hansung-capstone-team-8-new-line/deskpet-hardware/hardware-design/case-3d/check-report.txt

DeskPet 케이스 3D 모델 rev E 검사 (앞면 전체 LCD · 둥근 외형, [추정] 값은 실측 후 deskpet_case.py 치수 표에서 수정)
외형 192 × 150 × 134 mm (귀 포함 높이 174, 아래로 발 7 + 범퍼 2 mm 별도)
앞틀 192 × 128 mm 중 LCD 유리 164.9 × 106.96 = 72%, 테두리 좌우 13.5 · 위아래 13.5 mm, 창 162.9 × 105.0 (표시 영역 154.21 × 85.92는 모두 보임)

[PASS] 출력물·부품끼리 겹침 없음
[PASS] 배선이 출력물을 뚫지 않음
[PASS] Jetson 팬 위 공기층 30 mm 비어 있음
[PASS] 귀가 ±30° 돌 때 부딪힘 없음 (멈춤 나사 포함)
[PASS] 귀를 ±40°까지 돌리면 멈춤 나사에 걸림 (최소 겹침 5.1 mm³ → 서보 스톨 전에 기계적으로 멈춤)
[PASS] 뒤판을 열지 않고 Jetson 트레이를 뒤로 끝까지 뺄 수 있음
[PASS] 귀 1개 무게 8.8 g (속 채움 100% 상한, 기준 10 g 이하)
    참고: P1 바닥판 바닥 2 mm 안 수평 다리 75 mm² (나사 머리 자리·혼 홈 등)
    참고: P3 윗판 바닥 2 mm 안 수평 다리 90 mm² (나사 머리 자리·혼 홈 등)
    참고: P6 왼쪽 귀 바닥 2 mm 안 수평 다리 60 mm² (나사 머리 자리·혼 홈 등)
    참고: P6 오른쪽 귀 바닥 2 mm 안 수평 다리 60 mm² (나사 머리 자리·혼 홈 등)
[PASS] 출력 방향에서 바닥 2 mm 안에 45°보다 눕힌 경사면 없음 (첫 층부터 받침이 있음)

출력 범위 (출력 방향 기준 가로 × 세로 × 높이) · 무게는 속 채움 100% PLA 기준 상한
  [PASS] P1 바닥판        192 × 150 × 10 mm  부피   81.4 cm³  최대   101 g  출력 가능: X1C · H2D
  [PASS] P2 몸통        192 × 128 × 148 mm  부피  121.8 cm³  최대   151 g  출력 가능: X1C · H2D
  [PASS] P3 윗판         188 × 147 × 10 mm  부피   82.8 cm³  최대   103 g  출력 가능: X1C · H2D
  [PASS] P4 뒤판         187 × 128 × 11 mm  부피   40.8 cm³  최대    51 g  출력 가능: X1C · H2D
  [PASS] P5 트레이        136 × 106 × 49 mm  부피   37.4 cm³  최대    46 g  출력 가능: X1C · H2D
  [PASS] P6 왼쪽 귀         50 × 31 × 40 mm  부피    7.1 cm³  최대     9 g  출력 가능: X1C · H2D
  [PASS] P7 스피커 받침        74 × 34 × 6 mm  부피    3.0 cm³  최대     4 g  출력 가능: X1C · H2D
  [PASS] P8 발 ×4        166 × 124 × 7 mm  부피   13.1 cm³  최대    16 g  출력 가능: X1C · H2D

참고: LCD 오른쪽 끝 x=178.45, 옆벽 안쪽 x=189.5. 남는 11.1 mm에 HDMI FPC ㄱ자 플러그(8.6 mm)와 ㄱ자 micro USB(7 mm)를 넣었다. 일자 플러그·일반 ㄱ자 HDMI 젠더(약 20 mm 이상)는 들어가지 않는다.

H2D 출력 계획 (한 번에 300 g까지, 퍼지·브림 몫 10%를 빼고 물체 무게 상한 270 g 이하, 속 채움 100% PLA 기준 · 물체 간격 20 mm · 가운데 275 × 300 mm 안)
  [PASS] 시험 H2D-0-P2-fit-test.3mf: P2 앞틀 시험편 12 mm (판 위 192 × 128 × 12 mm) · 최대 28 g
  [PASS] 1회차 H2D-1-P2-body-P7-P8-feet.3mf: P2 몸통, P7 스피커 받침, P8 발 1, P8 발 2, P8 발 3, P8 발 4 (판 위 258 × 183 × 148 mm) · 최대 171 g
  [PASS] 2회차 H2D-2-P1-base-P4-back.3mf: P1 바닥판, P4 뒤판 (판 위 192 × 298 × 11 mm) · 최대 152 g
  [PASS] 3회차 H2D-3-P3-top-P5-tray-P6-ears.3mf: P3 윗판, P5 트레이, P6 왼쪽 귀, P6 오른쪽 귀 (판 위 206 × 273 × 49 mm) · 최대 167 g
  본 출력 합계 최대 489 g (시험편 제외)

결과: 모든 검사 통과
