hansung-capstone-team-8-new-line/deskpet-hardware/hardware-design/case-3d/renders/03-inside-back-right.png

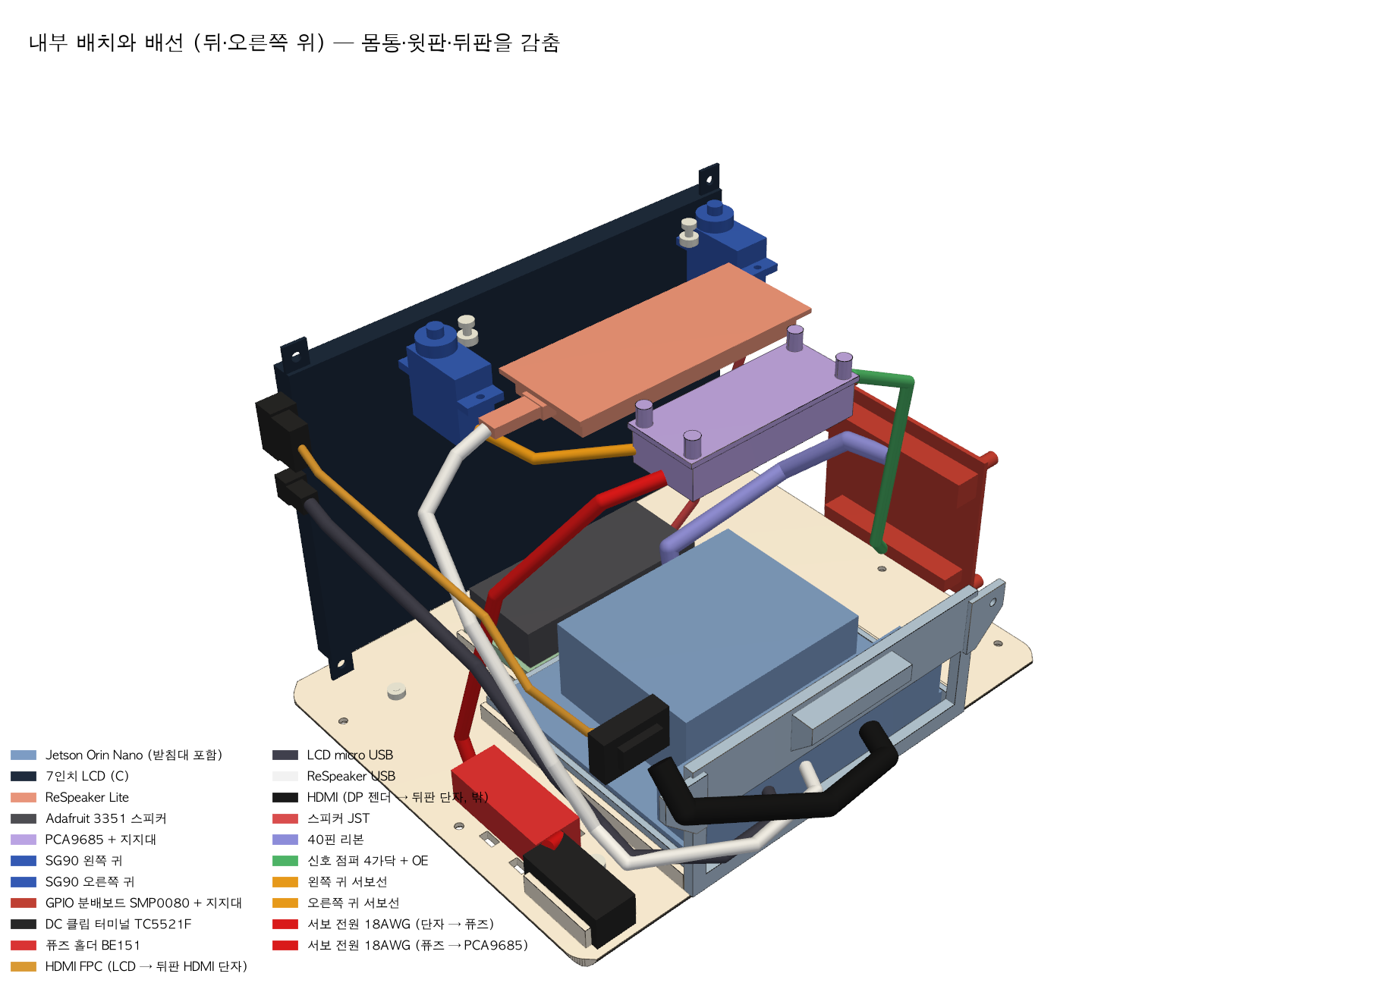
hardware-design/case-3d/renders/03-inside-back-right.png
