hansung-capstone-team-8-new-line/deskpet-hardware/hardware-design/case-3d/renders/03b-inside-front-left.png

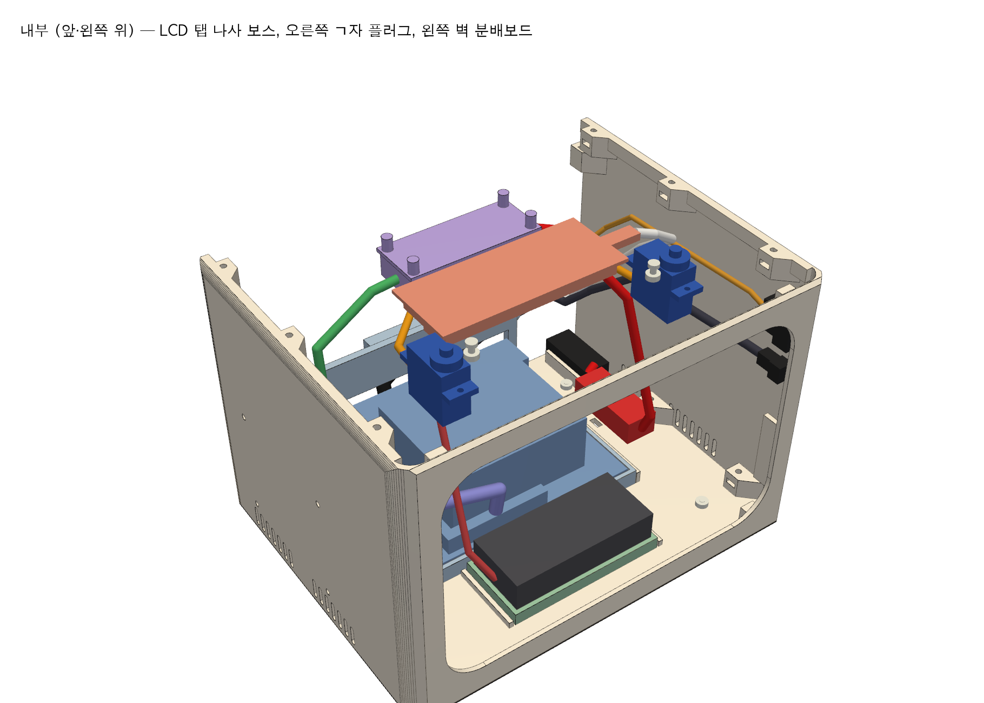
hardware-design/case-3d/renders/03b-inside-front-left.png
