hansung-capstone-team-8-new-line/deskpet-hardware/hardware-design/case-3d/renders/04-top-plate-underside.png

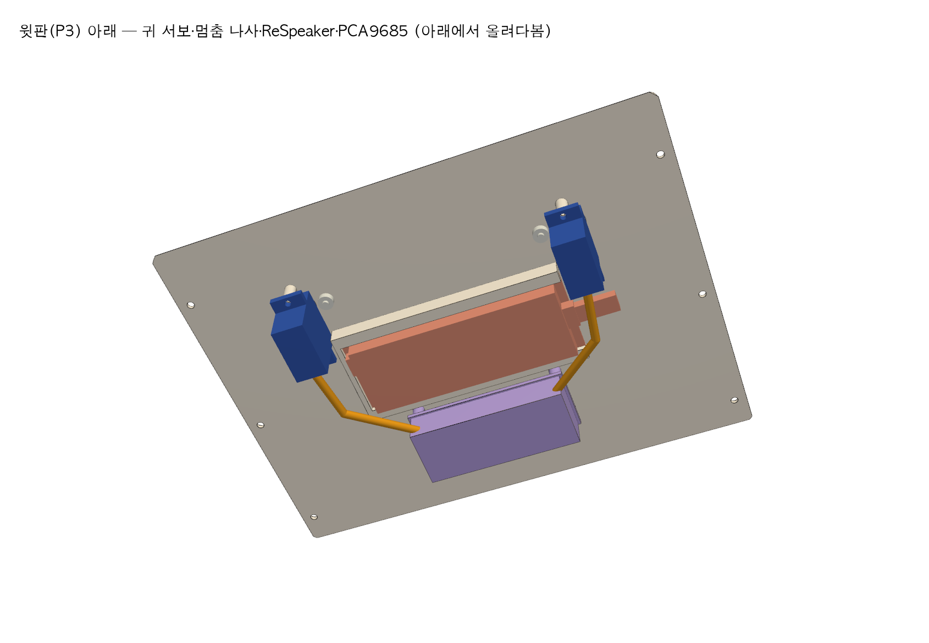
hardware-design/case-3d/renders/04-top-plate-underside.png
