hansung-capstone-team-8-new-line/deskpet-hardware/hardware-design/case-3d/renders/05-exploded.png

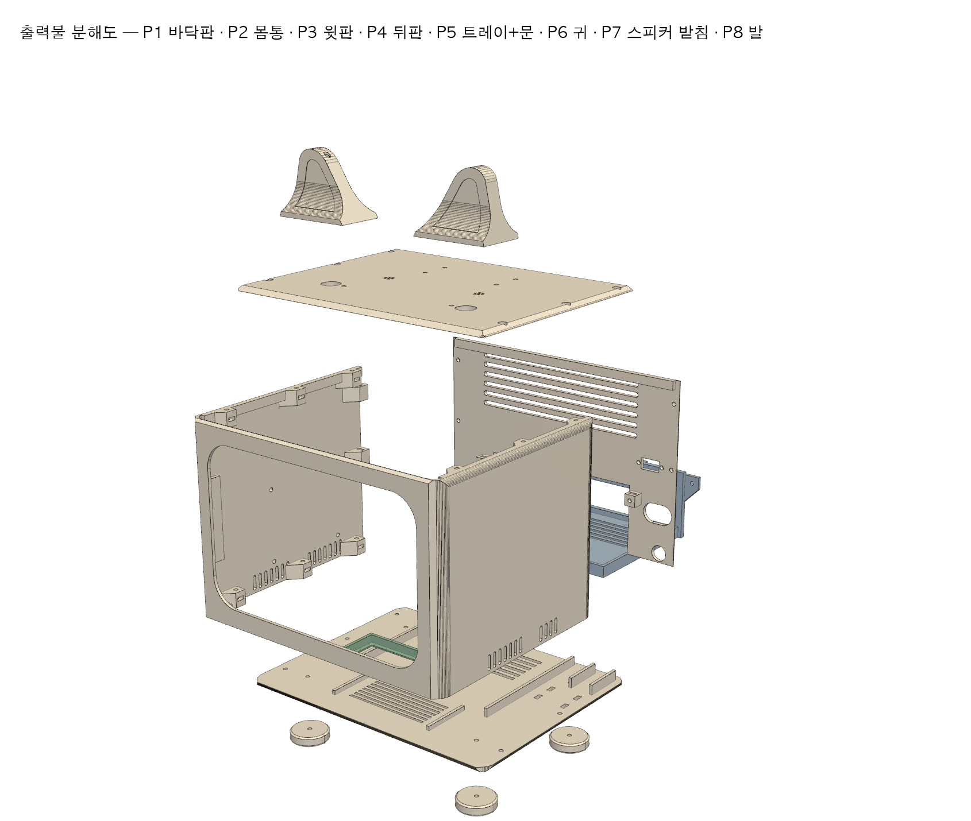
hardware-design/case-3d/renders/05-exploded.png
