hansung-capstone-team-8-new-line/deskpet-hardware/hardware-design/kicad-wiring/deskpet-schematic.png

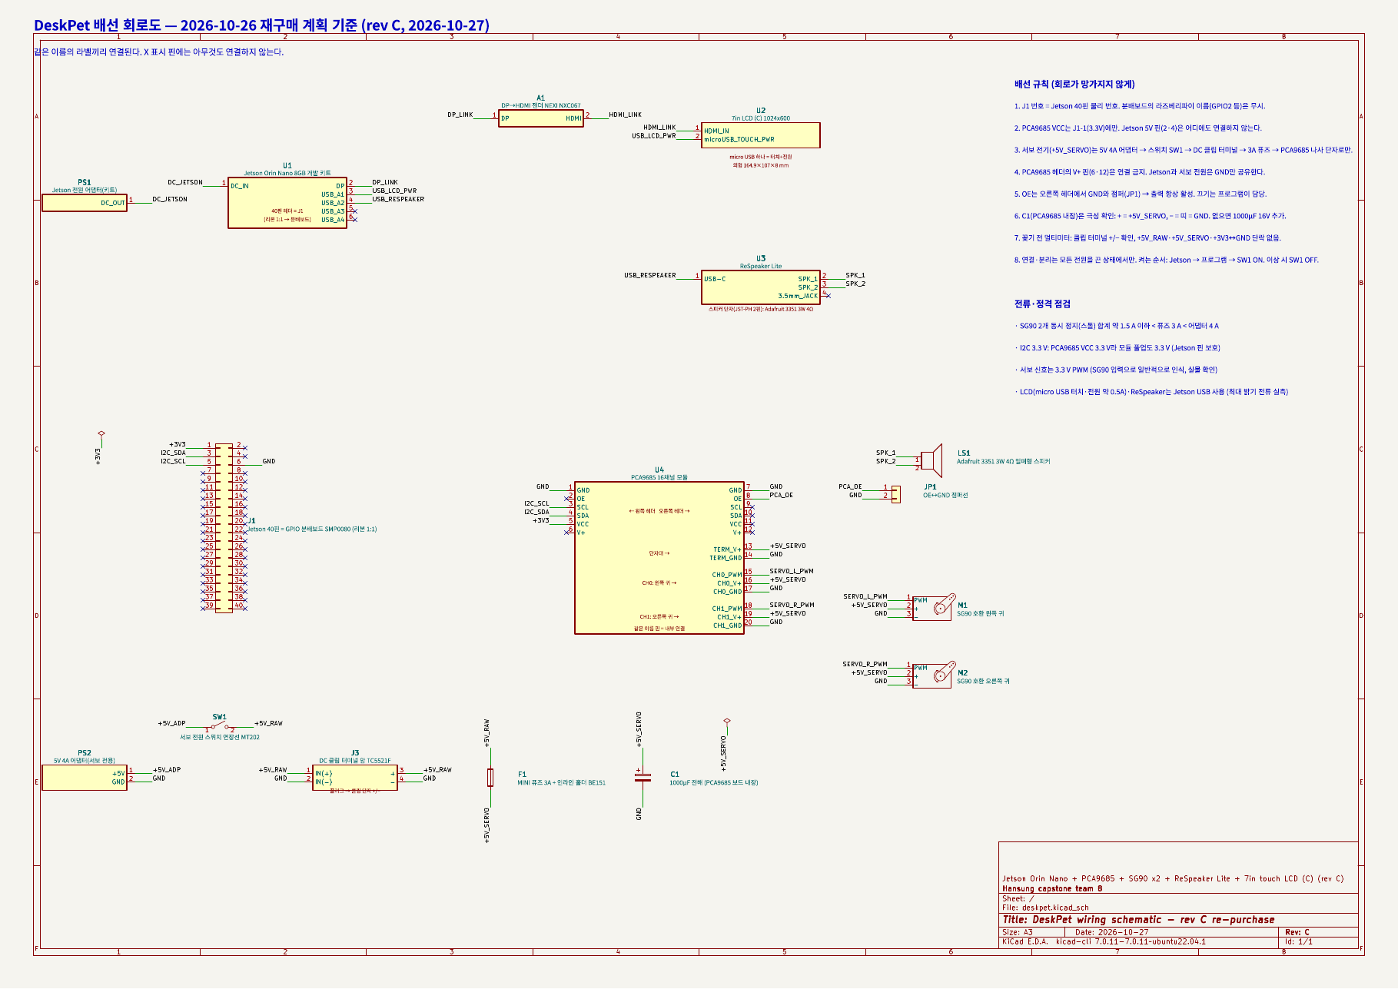
hardware-design/kicad-wiring/deskpet-schematic.png
