hansung-capstone-team-8-new-line/deskpet-hardware/hardware-design/case-3d/deskpet-case-assembly.step

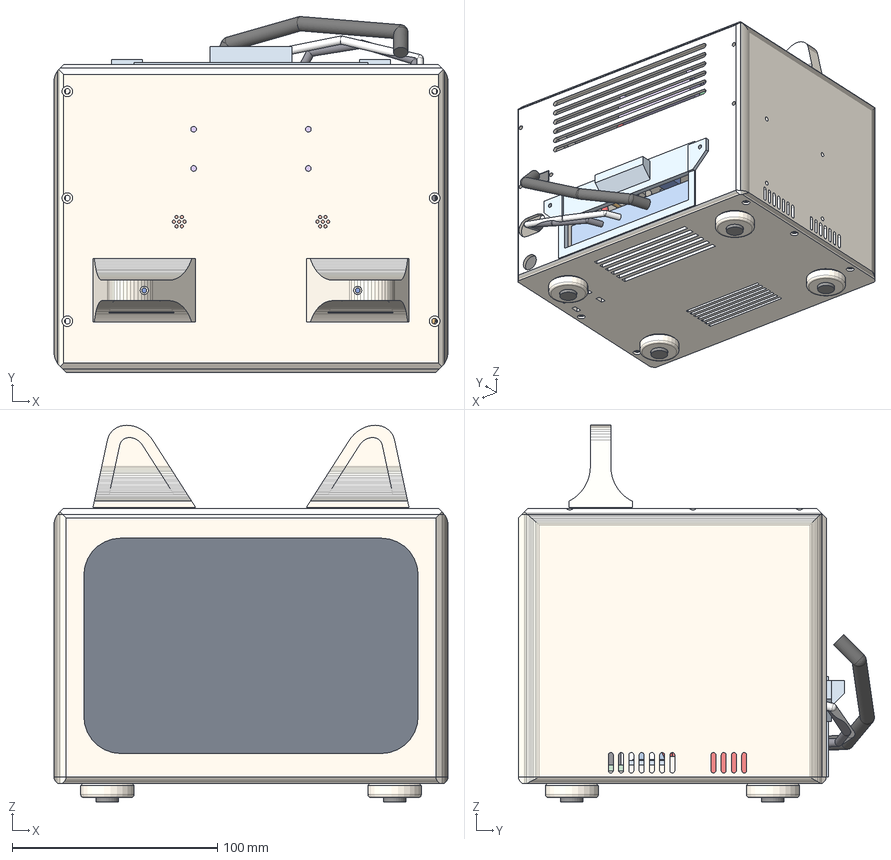
[picture p10: CAD file, 2026-11-09]
hardware-design/case-3d/deskpet-case-assembly.step
192.0 x 173.5 x 183.5 mm
P1 ë°ë¥í
P2 ëª¸íµ
P3 ìí
P4 ë¤í
P5 í¸ë ì´
P6 ì¼ìª½ ê·
P6 ì¤ë¥¸ìª½ ê·
P7 ì¤í¼ì»¤ ë°ì¹¨
P8 ë° Ã4
Jetson Orin Nano (ë°ì¹¨ë í¬í¨)
7ì¸ì¹ LCD (C)
HDMI FPC ã±ì íë¬ê·¸
micro USB ã±ì íë¬ê·¸
HDMI FPC ì ë¨ì ë³´ë
ReSpeaker Lite
Adafruit 3351 ì¤í¼ì»¤
PCA9685 + ì§ì§ë
SG90 ì¼ìª½ ê·
SG90 ì¤ë¥¸ìª½ ê·
ê· ë©ì¶¤ ëì¬ M2.5 Ã2
GPIO ë¶ë°°ë³´ë SMP0080 + ì§ì§ë
DC í´ë¦½ í°ë¯¸ë TC5521F
í¨ì¦ íë BE151
ì¤ë¦¬ì½ ë²í¼ Ã4
ë° ëì¬ M2.5 Ã8 + ëí¸ Ã4
HDMI FPC (LCD â ë¤í HDMI ë¨ì)
LCD micro USB
ReSpeaker USB
HDMI (DP ì ë â ë¤í ë¨ì, ë°)
ì¤í¼ì»¤ JST
40í ë¦¬ë³¸
ì í¸ ì í¼ 4ê°ë¥ + OE
ì¼ìª½ ê· ìë³´ì
ì¤ë¥¸ìª½ ê· ìë³´ì
ìë³´ ì ì 18AWG (ë¨ì â í¨ì¦)
ìë³´ ì ì 18AWG (í¨ì¦ â PCA9685)
