hansung-capstone-team-8-new-line/deskpet-hardware/hardware-design/case-3d/3mf/H2D-3-P3-top-P5-tray-P6-ears.3mf

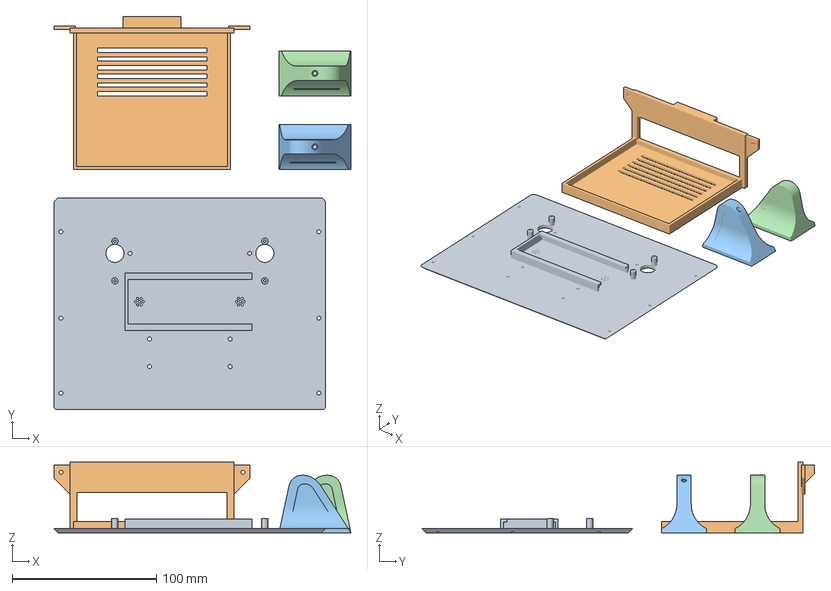
[picture p11: CAD file, 2026-11-09]
hardware-design/case-3d/3mf/H2D-3-P3-top-P5-tray-P6-ears.3mf
206.0 x 272.6 x 49.0 mm
