hansung-capstone-team-8-new-line/deskpet-hardware/hardware-design/case-3d/stl/P2-body.stl

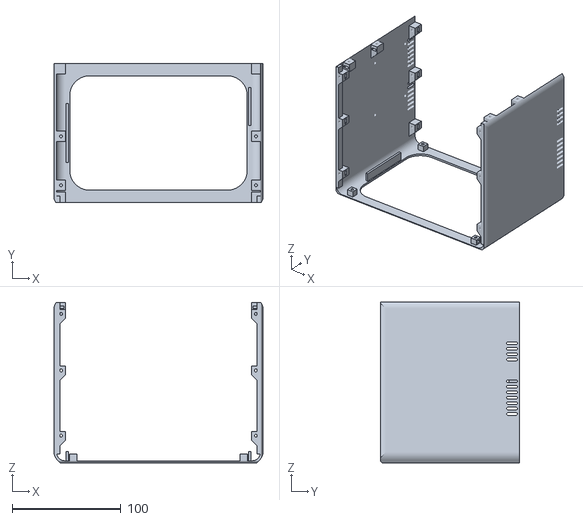
[picture p12: CAD file, 2026-11-09]
hardware-design/case-3d/stl/P2-body.stl
192.0 x 128.0 x 147.8
