hansung-capstone-team-8-new-line/deskpet-hardware/hardware-design/case-3d/3mf/H2D-0-P2-fit-test.3mf

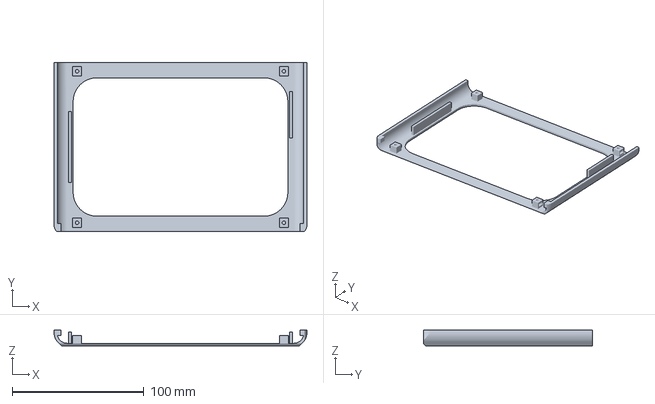
[picture p13: CAD file, 2026-11-09]
hardware-design/case-3d/3mf/H2D-0-P2-fit-test.3mf
192.0 x 128.0 x 12.0 mm
