hansung-capstone-team-8-new-line/deskpet-hardware/hardware-design/case-3d/stl/P5-tray-door.stl

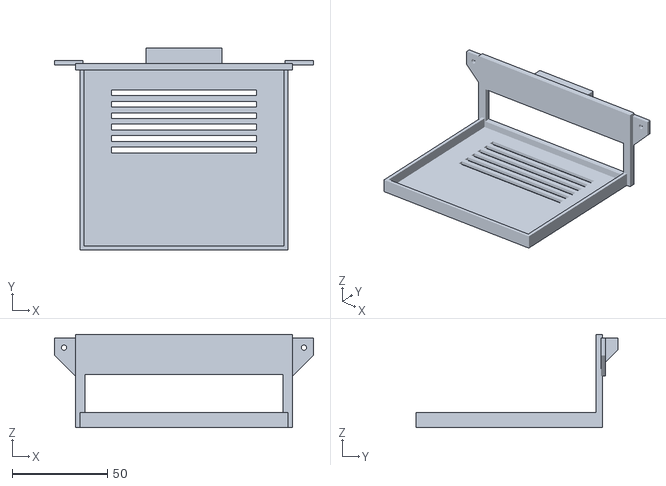
[picture p14: CAD file, 2026-11-09]
hardware-design/case-3d/stl/P5-tray-door.stl
136.0 x 106.0 x 49.0
