hansung-capstone-team-8-new-line/deskpet-hardware/hardware-design/case-3d/3mf/H2D-1-P2-body-P7-P8-feet.3mf

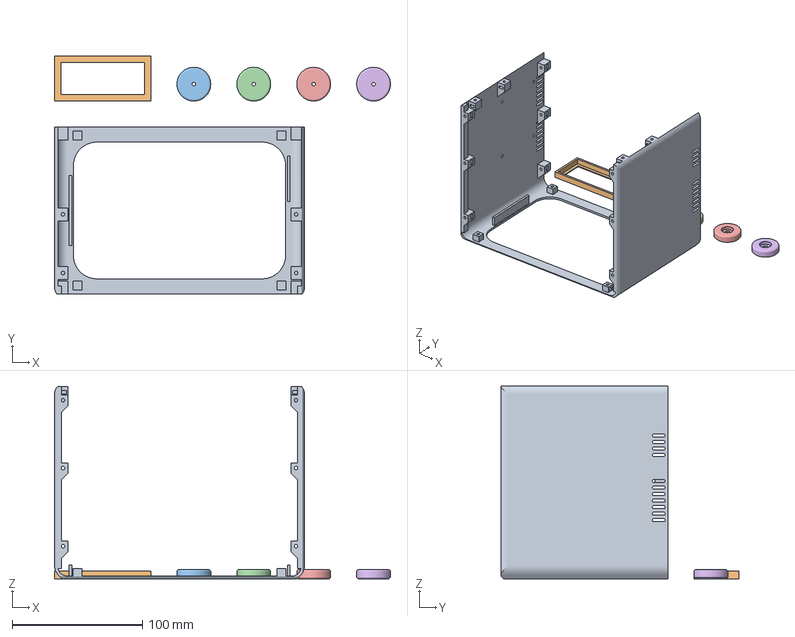
[picture p15: CAD file, 2026-11-09]
hardware-design/case-3d/3mf/H2D-1-P2-body-P7-P8-feet.3mf
258.0 x 182.5 x 147.8 mm
