hansung-capstone-team-8-new-line/deskpet-hardware/hardware-design/case-3d/stl/P3-top.stl

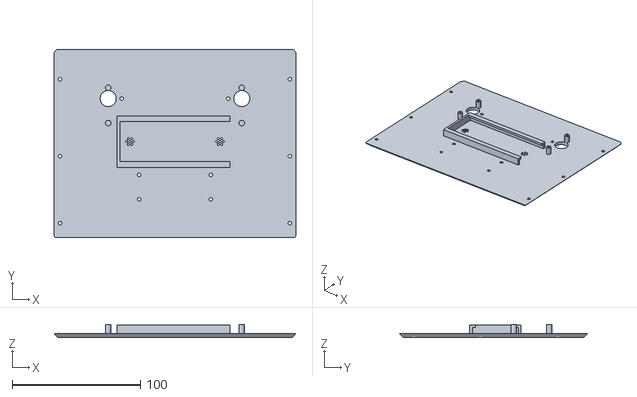
[picture p16: CAD file, 2026-11-09]
hardware-design/case-3d/stl/P3-top.stl
188.5 x 146.6 x 9.80
