hansung-capstone-team-8-new-line/deskpet-hardware/hardware-design/case-3d/3mf/H2D-2-P1-base-P4-back.3mf

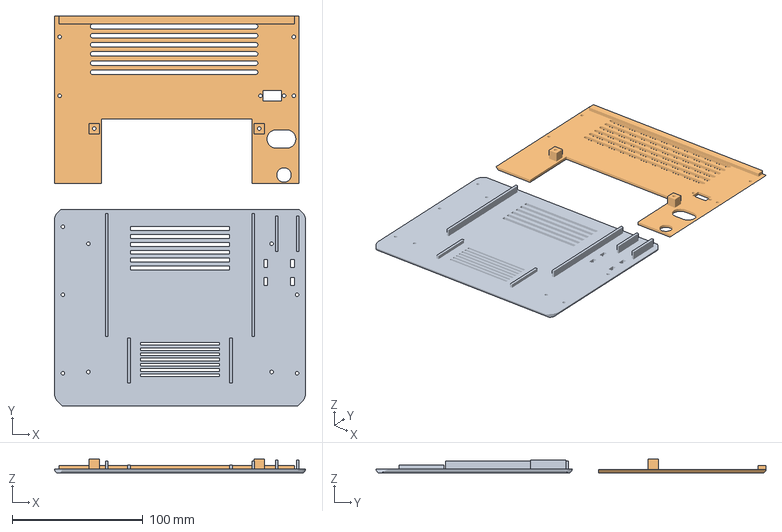
[picture p17: CAD file, 2026-11-09]
hardware-design/case-3d/3mf/H2D-2-P1-base-P4-back.3mf
192.0 x 298.0 x 10.5 mm
