hansung-capstone-team-8-new-line/deskpet-hardware/hardware-design/case-3d/stl/P1-base.stl

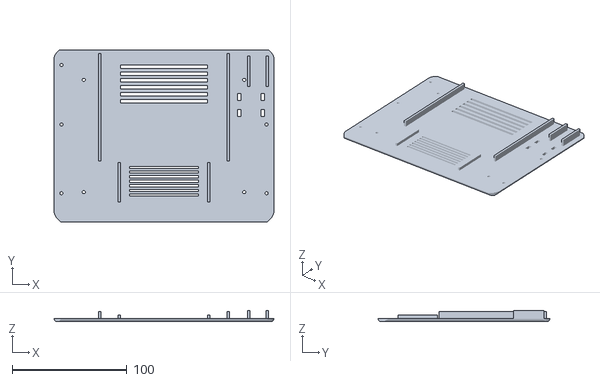
[picture p18: CAD file, 2026-11-09]
hardware-design/case-3d/stl/P1-base.stl
192.0 x 150.0 x 10.00
