hansung-capstone-team-8-new-line/deskpet-hardware/hardware-design/case-3d/stl/P8-foot-x4.stl

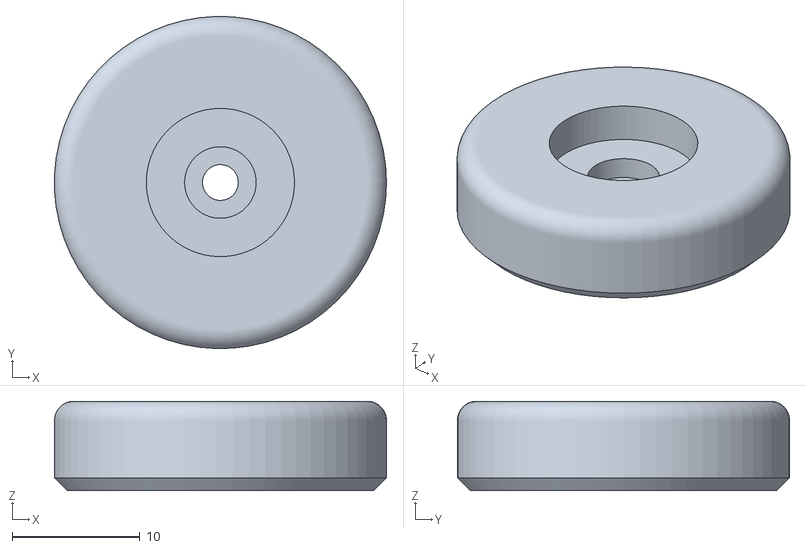
[picture p19: CAD file, 2026-11-09]
hardware-design/case-3d/stl/P8-foot-x4.stl
26.0 x 26.0 x 7.00
