hansung-capstone-team-8-new-line/deskpet-hardware/hardware-design/case-3d/stl/P4-back.stl

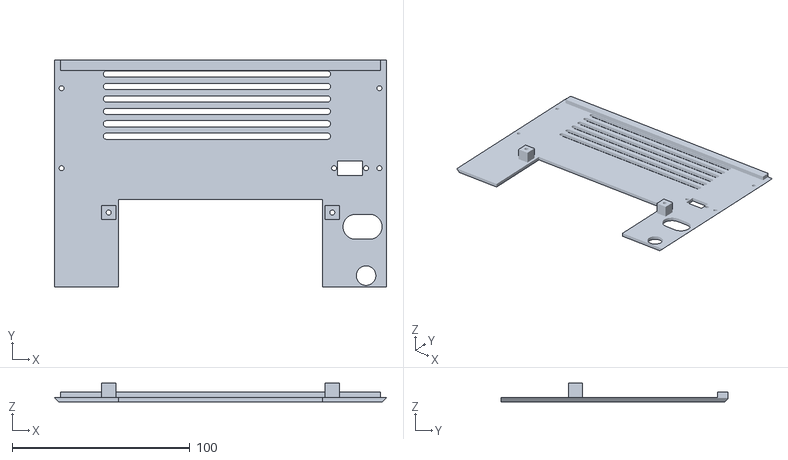
[picture p20: CAD file, 2026-11-09]
hardware-design/case-3d/stl/P4-back.stl
187.0 x 128.0 x 10.5
