hansung-capstone-team-8-new-line/deskpet-hardware/hardware-design/case-3d/stl/P6-ear-left.stl

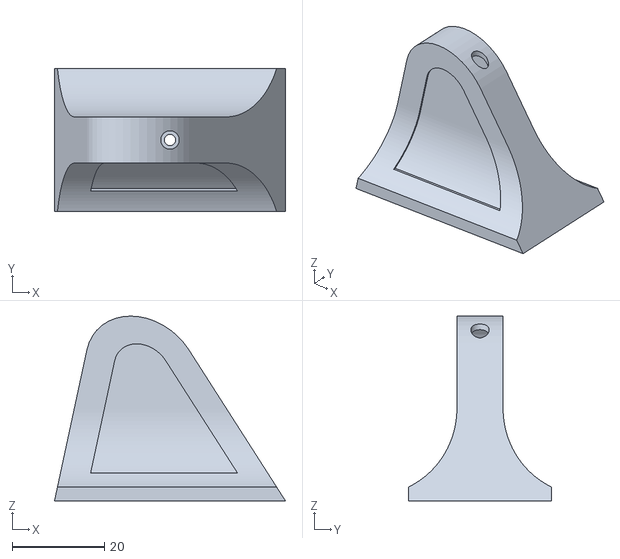
[picture p21: CAD file, 2026-11-07]
hardware-design/case-3d/stl/P6-ear-left.stl
50.0 x 31.0 x 40.0
