hansung-capstone-team-8-new-line/deskpet-hardware/hardware-design/case-3d/stl/P7-speaker-cradle.stl

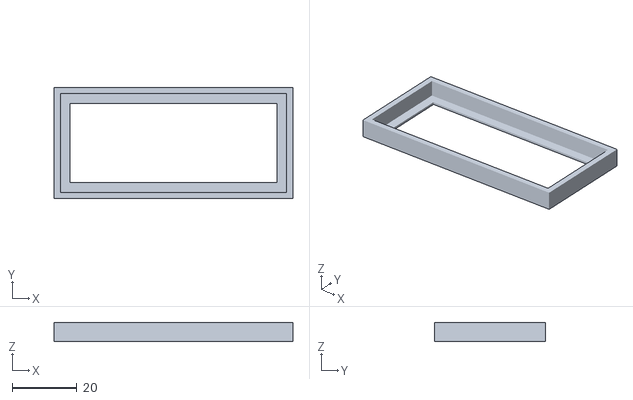
[picture p22: CAD file, 2026-11-07]
hardware-design/case-3d/stl/P7-speaker-cradle.stl
74.0 x 34.5 x 6.00
