hansung-capstone-team-8-new-line/deskpet-hardware/(list of files, cad)

Other CAD files:
hardware-design/case-3d/stl/P6-ear-right.stl
