hansung-capstone-team-8-new-line/deskpet-hardware/hardware-design/case-3d/PRINTING.md

# 케이스 출력 안내 (Bambu Lab H2D, rev E)

출력물 8종(P1~P8)을 **H2D 한 대에서 본 출력 3회 + 맞춤 시험 1회**로 뽑습니다. 한 번에 출력할 수 있는 양이 **300 g**이고, 판 위 물체를 **20 mm 이상** 띄워 브림과 떼어내기 여유를 두었습니다. `build.py`가 판마다 ① 물체 무게 상한이 270 g(퍼지·브림 몫 10%를 뺀 값) 이하인지, ② 배치가 판 가운데 275 × 300 mm 안에 드는지(양옆 "한쪽 노즐 전용" 띠를 피함) 검사하고(`check-report.txt` 아래쪽), 넘으면 실패로 끝납니다.

`stl/`은 출력 방향으로 돌려 둔 부품별 파일이고, `3mf/`는 그 부품을 아래 계획대로 H2D 판(325 × 320) 가운데에 배치해 둔 파일입니다.

> **본 출력 전에:** LCD·Jetson 등 부품이 도착하면 [README](README.md) 맨 아래 `[추정]` 값을 실측해 고치고 `build.py`를 다시 실행하세요. 1회차(P2)는 LCD 탭 깊이·단자 위치, 2·3회차(P1·P3)는 PCA9685 구멍·ReSpeaker·마이크 위치에 영향을 받습니다.

## 출력 계획

| 순서 | 파일 | 출력물 | 판 위 크기 (mm) | 무게 상한* |
| --- | --- | --- | --- | ---: |
| 0. 시험 | `3mf/H2D-0-P2-fit-test.3mf` | P2 앞틀 시험편 (앞면부터 12 mm) | 192 × 128 × 12 | 28 g |
| 1회차 | `3mf/H2D-1-P2-body-P7-P8-feet.3mf` | P2 몸통, P7 스피커 받침, P8 발 4개 | 258 × 183 × 148 | 171 g |
| 2회차 | `3mf/H2D-2-P1-base-P4-back.3mf` | P1 바닥판, P4 뒤판 | 192 × 298 × 11 | 152 g |
| 3회차 | `3mf/H2D-3-P3-top-P5-tray-P6-ears.3mf` | P3 윗판, P5 트레이+문, P6 귀 2개 | 206 × 273 × 49 | 167 g |
| | | **본 출력 합계** | | **489 g** |

\* 속 채움 100% PLA(1.24 g/cm³)로 계산한 **상한**입니다. 실제 슬라이서 값은 아래 설정(벽 3, 속 채움 20%)에서 이보다 적게 나옵니다(대략 20~40% 적을 것으로 추정). **보내기 전에 Bambu Studio의 슬라이스 결과에 나온 무게가 300 g 이하인지 확인**하세요(퍼지·브림 포함 값).

나눈 이유:

- **1회차 = 키 큰 P2.** 높이 148 mm라 가장 오래 걸리고 실패 위험도 가장 큽니다. 같은 판에는 작은 P7·발만 넣어, 실패해도 잃는 양이 적습니다.
- **2회차 = 납작한 판 두 장.** P1·P4는 높이 11 mm 이하라 빨리 끝납니다.
- **3회차 = P3과 작은 부품.** P5(높이 49)와 귀(높이 40)를 P3 앞쪽에 둡니다.
- 판마다 270 g보다 100 g 가까이 여유가 있어 브림을 키우거나 시험편을 다시 넣어도 넘지 않습니다.

순서는 **시험 → 실측값 수정·재생성 → 1회차 → 2회차 → 3회차**입니다. 2·3회차는 서로 순서를 바꿔도 됩니다.

**3MF 여는 법:** Bambu Studio → 파일 → 가져오기 → 3MF. "기하만 불러오기" 안내가 나오면 예를 누릅니다. 프린터 H2D·노즐 0.4·텍스처드 PEI 판을 고르고, 한 노즐(왼쪽 또는 오른쪽)에 PLA Basic 한 가지만 지정합니다. 물체 위치를 옮기면 판 양옆의 "Left/Right nozzle only area" 띠에 걸치지 않게, 물체끼리는 20 mm 이상 띄워 두세요.

## 재료: Bambu PLA Basic 한 가지

| 출력물 | 재료 | 이유 |
| --- | --- | --- |
| P1~P8 전부 | **Bambu PLA Basic**, 흰색·밝은 회색 권장 | 가지고 있는 필라멘트. 아크릴(시타델) 도료가 PETG보다 잘 붙음. 필라멘트 교체·두 노즐 출력이 필요 없음 |
| 맞춤 시험편 | PLA Basic | 맞춤 확인용 |

**열 주의:** PLA Basic은 약 55~57 °C부터 물러집니다. Jetson을 오래 세게 돌리면 케이스 안, 특히 P5 트레이·P4 뒤판(배기)·P3 윗판(팬 위)이 그 근처까지 데워질 수 있습니다(실측 전 추정). Jetson은 키트 받침대째 얹혀 보드가 PLA에 직접 닿지 않고 팬 위 30 mm 공기층과 흡기·배기 길이 있어 대개 괜찮지만, 다음을 지킵니다.

1. 조립 후 첫 시험에서 Jetson에 30분~1시간 부하를 걸고 `tegrastats`로 온도를 보며 P4·P5·P3을 만져 봅니다. 손으로 오래 대기 어려울 만큼 뜨겁거나 말랑해지면 문제입니다.
2. 문제가 생기면 Jetson 전력 모드를 낮추거나(`nvpmodel`), **P4·P5만 PETG 등으로 다시 출력**합니다(합계 약 100 g).
3. 직사광선·여름 차 안 같은 곳에 두지 않습니다.

색은 시타델 도료로 칠하므로 출력 색은 상관없습니다. 밑칠이 잘 덮이도록 흰색이나 밝은 회색이 편합니다.

## 공통 설정 (0.4 노즐)

| 항목 | 값 |
| --- | --- |
| 층 높이 | 0.20 mm (3회차는 귀 곡면을 위해 0.16 mm도 좋음) |
| 벽 루프 | 3 (귀 벽 1.2 mm는 3이면 꽉 참. 도색 자리 아래는 0.8 mm = 2줄) |
| 위/아래 층 | 4 / 4 |
| 속 채움 | 20% 자이로이드 |
| 서포트 | **끔** (모든 경사를 45° 이하로 설계) |
| 판 | 텍스처드 PEI (풀 불필요) |
| 브림 | P2만 5 mm (높이 148, 무게중심이 높음). Bambu Studio에서 P2 물체에만 브림을 켭니다 |
| 이음매 | 뒤쪽 정렬 (앞틀 정면에 이음매가 보이지 않게) |

출력물별 주의:

- **P2 몸통:** 앞면이 바닥이라 첫 층이 그대로 정면 마감이 됩니다. 판을 닦고 첫 층 속도를 낮추세요. 바닥에 닿는 둥근 모서리는 모두 45° 직선으로 시작하게 만들어 서포트가 필요 없습니다(`build.py` "첫 층 들뜸" 검사). P1·P3·P4도 같습니다.
- **P3 윗판:** 윗면이 바닥입니다. 레일 끝 걸림턱(돌출 2.5 mm)은 서포트 없이 출력됩니다.
- **P4 뒤판:** 바깥면이 바닥입니다. 문 나사 너트 보스가 위로 섭니다.
- **P5 트레이+문:** 문 밑면이 트레이 밑면과 같은 높이라 둘 다 바닥에 닿습니다. 문의 Jetson 단자 창 윗변이 약 104 mm 다리(bridge)입니다. 처지면 그 부분만 서포트를 칠하세요(서포트 칠하기 → 창 윗변).
- **P6 귀:** 귀 뿌리 밑면이 바닥이고 속이 열려 있습니다. 뿌리 곡면은 밑에서 26°로 시작해 서포트가 필요 없습니다. 왼쪽과 오른쪽은 멈춤 홈 방향과 기운 방향이 달라 서로 바꿔 끼우면 안 됩니다. 혼 팔은 **뒤쪽 한 방향**만 홈이 있으니 SG90 혼의 팔 하나를 13 mm로 잘라 씁니다.
- **P8 발:** 위면(바닥판에 닿는 면, 둘레 1 mm 모따기)이 바닥입니다. 범퍼 자리(Ø11.6, 깊이 3)와 나사 머리 자리가 위로 열립니다.

## 맞춤 시험 (0번, 먼저 권장)

LCD가 도착하면 P2 전체를 뽑기 전에 `3mf/H2D-0-P2-fit-test.3mf`(앞틀 앞쪽 12 mm)를 출력합니다. 앞틀·창·LCD 탭 보스·좌우 리브와 둥근 모서리 첫 층이 포함됩니다.

1. LCD를 대어 봅니다: 탭 구멍과 보스 구멍이 맞는지, 유리가 앞틀에 고르게 닿는지, 오른쪽 HDMI FPC·micro USB ㄱ자 플러그가 옆벽에 닿지 않는지.
2. 어긋나면 `deskpet_case.py`의 `LCD` 표를 고치고 `build.py`를 다시 실행합니다(3MF도 다시 만들어집니다).

## 도색 (시타델 도료)

귀 앞면 안쪽은 **0.4 mm 낮춘 도색 자리**입니다. 이 턱을 경계선 삼아 분홍을 칠하면 선이 깔끔하게 나옵니다(그림의 분홍 부분).

1. 바깥에 보이는 부품(P1~P4, P6, P8)을 가볍게 사포질(400~600방)하고 먼지를 닦습니다.
2. 시타델 스프레이 프라이머(예: Wraithbone, White Scar)를 얇게 두 번 뿌립니다.
3. 몸통 색 → 귀 안쪽 분홍 순으로 칠하고, 다 마르면 무광 바니시(예: Munitorum Varnish)로 마감합니다.
4. 실리콘 범퍼와 나일론 나사는 도료가 붙지 않습니다. **발은 칠한 뒤에 범퍼를 붙이고**, 나사 머리는 칠하지 않거나 프라이머로 시험해 봅니다.
5. 끼워 맞추는 면(트레이 레일, 귀 허브 아래, LCD가 닿는 앞틀 안쪽, 나사 구멍)은 칠하지 않습니다. 도막 두께만큼 빡빡해집니다.

## 조립에 필요한 것 (케이스 관련)

| 품목 | 수량 | 비고 |
| --- | --- | --- |
| M2.5 나일론 나사 + 너트 | 33쌍 | 판 결합 15, 문 2, LCD 탭 4, 귀 멈춤 2, HDMI 단자 보드 2, PCA9685 4, **발 4(M2.5 × 8)** (BRT 세트). 분배보드 지지대는 별도 |
| HDMI FPC 리본 키트 | 1 | 구매 완료. LCD 쪽 A수 90° 위/아래 꺾임(돌출 9 mm 이하) + 리본 + A암 패널형 보드. 꺾임 방향은 LCD 실물로 확인 |
| ㄱ자 micro USB 케이블 | 1 | 구매 완료. 위/아래 꺾임, 머리 돌출 7 mm 이하, USB-A 쪽은 Jetson으로 |
| 짧은 HDMI 케이블 (A수-A수) | 1 | DP→HDMI 젠더 ↔ 뒤판 HDMI 단자. LCD 동봉 케이블 사용 가능 |
| 실리콘 범퍼 Ø11 × 5 | 4 | P8 발 바닥 자리에 3 mm 묻혀 2 mm만 보임 |
| EVA 테이프 | 조금 | 스피커 받침 가장자리, 트레이가 헐거울 때 |
