hansung-capstone-team-8-new-line/deskpet-hardware/hardware-design/kicad-wiring/wiring-table.csv

번호 | 출발 | 도착 | 선·부품 | 색 | 넷
R | Jetson 40핀 헤더 | GPIO 분배보드 SMP0080 | 40p 무지개 리본(세트 동봉) | 1번 = 리본 첫 줄 | 리본 1:1
W1 | 분배보드 1번 (3.3V) | PCA9685 왼쪽 헤더 VCC | F/F 점퍼 | 빨강 | +3V3
W2 | 분배보드 3번 (SDA) | PCA9685 왼쪽 헤더 SDA | F/F 점퍼 | 파랑 | I2C_SDA
W3 | 분배보드 5번 (SCL) | PCA9685 왼쪽 헤더 SCL | F/F 점퍼 | 노랑 | I2C_SCL
W4 | 분배보드 6번 (GND) | PCA9685 왼쪽 헤더 GND | F/F 점퍼 | 검정 | GND
W5 | PCA9685 오른쪽 헤더 OE | PCA9685 오른쪽 헤더 GND | 짧은 F/F 점퍼 (JP1) | 초록 | GND, PCA_OE
W6 | 5V 4A 어댑터 플러그 (코드 일체형) | 스위치 연장선 MT202 암 단자 (SW1) | 플러그 끼우기 | - | +5V_ADP
S1 | 스위치 연장선 MT202 수 플러그 | DC 클립 터미널 TC5521F | MT202 M/F 29cm, 처음엔 OFF | - | +5V_RAW, GND
W7 | 클립 터미널 + (테스터로 확인) | 퓨즈 홀더 BE151 한쪽 선 | 18AWG(XT30 선 절단) + 납땜·수축튜브 3/6mm | 빨강 | +5V_RAW
W8 | 퓨즈 홀더 다른 쪽 선 | PCA9685 단자대 V+ | 18AWG | 빨강 | +5V_SERVO
W9 | 클립 터미널 − | PCA9685 단자대 GND | 18AWG | 검정 | GND
W10 | PCA9685 내장 1000µF 확인 | 단자대 V+ / GND 옆 (기판 실장) | 확인만: 극성·용량 (없으면 1000µF 16V 추가) | - | +5V_SERVO, GND
W11 | SG90 호환 왼쪽 귀 플러그 | PCA9685 CH0 (갈색=GND, 빨강=V+, 주황=PWM) | 서보 선 그대로 | 갈·빨·주 | +5V_SERVO, GND, SERVO_L_PWM
W12 | SG90 호환 오른쪽 귀 플러그 | PCA9685 CH1 (같은 방향) | 서보 선 그대로 | 갈·빨·주 | +5V_SERVO, GND, SERVO_R_PWM
C1 | Jetson DP | DP→HDMI 젠더 → HDMI 케이블 → LCD HDMI | NXC067 + LCD 동봉 HDMI | - | DP_LINK, HDMI_LINK
C2 | Jetson USB-A | LCD micro USB (터치·전원) | LCD 동봉 USB-A→micro B 케이블 | - | USB_LCD_PWR
C3 | Jetson USB-A | ReSpeaker USB-C | HT-CA3100W USB-A→C 데이터 케이블 | - | USB_RESPEAKER
C4 | ReSpeaker 스피커 단자 | Adafruit 3351 밀폐형 스피커 | 스피커 JST-PH 케이블 | - | SPK_1, SPK_2
C5 | Jetson 전원 어댑터 | Jetson DC 입력 | 키트 동봉 | - | DC_JETSON
