hansung-capstone-team-8-new-line/deskpet-hardware/hardware-design/kicad-wiring/wiring-table.png

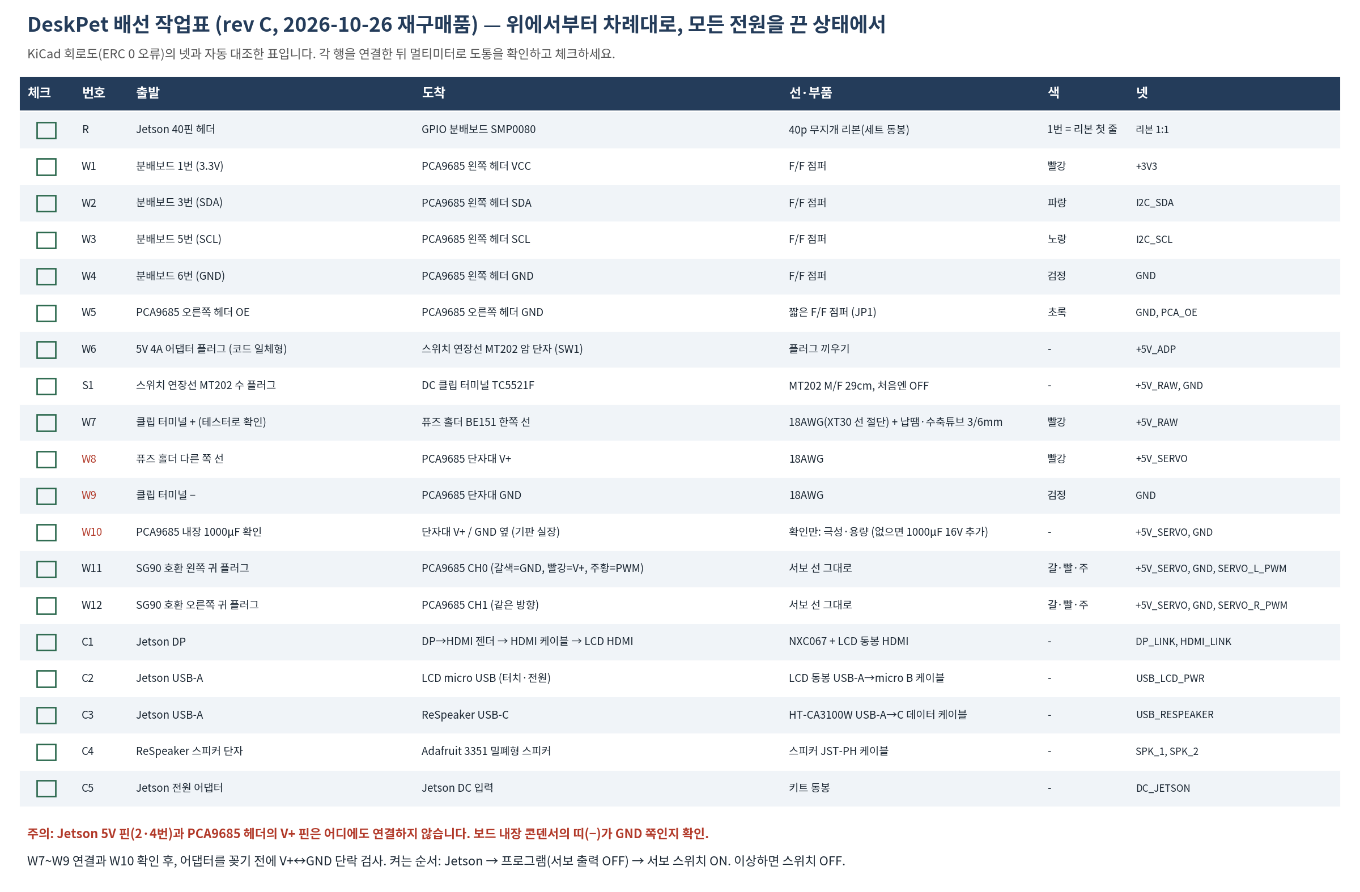
hardware-design/kicad-wiring/wiring-table.png
