hansung-capstone-team-8-new-line/deskpet-hardware/docs/validation.md

# 검증 기록과 실물 확인 절차

## 보드 시험 준비 검증 — 2026-10-25

Ubuntu 22.04 WSL **x86_64**, GCC 11.4, Swift **6.0.3**에서 현재 소스를 검증했습니다.

- C++20 ALSA·I2C·SoXR·SDL 드라이버 빌드, core·current-profile·실소켓 통합 22개 통과.
- 하드웨어 Swift strict-concurrency / warnings-as-errors 빌드, XCTest 9개 통과.
- 팀 파이프라인·새 연결부 Swift Testing 67개 통과. 단일 실제 Unix 소켓, 첫 24kHz PCM 형식 확정, 형식 변경 거절, 터치 전달, 16kHz 캡처, 1.5초 재생 중 입력 대기, 실제 완료+300ms 이후 fresh frame, 정지 불명 차단을 포함합니다.
- 취소 완료가 지연되는 STT fixture에서도 이전 epoch의 final이 context·업무 실행으로 전달되지 않았습니다.
- 60초 반복 실행 **101회**에서 음성 전달 완료를 확인했습니다. 장치·모델은 mock/fixture이며 실제 소켓·프로세스를 사용했습니다.
- 터치 0/90/180/270도 좌표, 중복 입력·이동 합치기·재접속, real 모드 합성 주입 거절, 서보 보정 전 거절·intensity 범위를 검사했습니다.
- SDL 화면 16종, 한글 overflow 거절·0/90도 회전 검사 통과. 설치 쉘 문법, Python 도구 문법, ARM64 Swift 다운로드 주소를 확인했습니다.
- 배포 소스를 별도 폴더에 풀어 111개 파일 SHA256을 대조하고 C++·두 Swift 패키지를 다시 빌드·시험했습니다. 5초 반복 실행 9회도 통과했습니다.

**Jetson ARM64, LCD·터치 패널, ReSpeaker, 서보·전원·열은 아직 미검증입니다.** 내일 [보드 시험 안내](board-test.md)의 `test-board.py --seconds 1800`을 보드에서 실행해 별도 판정합니다. 개발 PC 실행은 `boardAcceptance=SKIP`으로 기록합니다.

실행 도구는 단계 로그와 `result.json`을 생성하며 배포 묶음은 기준 커밋·작업 트리 변경·파일 SHA256을 `manifest.json`에 기록합니다.

## 소프트웨어 검증

**이 아래 2026-10-12 표는 당시 구현의 과거 기록이다.** 1024×600 화면·ReSpeaker·FULL_OFF·입력 게이트 변경의 검증은 아래 2026-10-13 항목을 따른다. 파이프라인 문서에는 10월 12일 Swift 매핑 작성 및 C++20 JSON/string 비교 빌드 실패가 별도 기록돼 있다. 이번 변경은 비교 타입을 명시했다. 당시 성공 기록으로 이후 빌드 실패를 덮지 않는다.

2026-10-12에 다음 검증을 실행해 통과했습니다. 아래의 모의 통신 시험은 실제 USB 오디오·PCA9685를 사용하지 않습니다.

| 환경 | 실행 결과 |
| --- | --- |
| macOS ARM64, AppleClang 15, Swift 5.10 | C++·SDL·Swift 빌드 성공. C++ core 및 통합 검사 통과: 통합 16개 중 15개 성공, Linux 전용 1개 제외. Swift 왕복 포함 |
| Ubuntu 22.04 ARM64 컨테이너, GCC 11 | ALSA 1.2.6.1·libgpiod 1.6.3·SDL2_ttf 2.0.18 실제 드라이버 빌드 성공. C++ core 및 통합 16개 모두 통과 |
| Linux Swift 6.0.3 | strict concurrency 및 warnings-as-errors 빌드 성공. XCTest 4개 통과 |
| macOS·Linux SDL 소프트웨어 렌더러 | 각 16개 화면 생성. 한글·텍스트 길이 거절·0/90도 회전 검사 통과. macOS 출력 이미지를 직접 확인 |
| macOS 독립 통합 데모 | 정상·스피커 오류 주입 두 경로 완료. 동시 캡처, 텍스트 대체, 질문 대기 15초 종료, 예약 알림, 텍스트 15초 복귀 확인 |

macOS에서는 Command Line Tools 환경에 XCTest가 없어 Swift 단위 검사를 실행하지 않았습니다. 해당 검사는 Linux에서 실행했습니다. Linux 검증은 ARM64 가상 머신 안의 Ubuntu 컨테이너에서 수행했으며 실제 Jetson의 커널·핀mux·그래픽 세션을 검증한 결과는 아닙니다. 검증용 가상 환경은 작업 후 제거했습니다.

테스트는 다음 동작을 검증합니다.

- 프로토콜 프레임 분할·병합, 한글과 바이너리 PCM, 길이 제한, 64비트 타임스탬프.
- PCM 형식·프레임 경계, 빈 재생 job 거절, 완료 이전 버퍼 drain, 재생 중 취소.
- 캡처·재생 동시 실행, 프레임 순서, WAV EOF와 마지막 프레임 패딩.
- 서버 스피커 큐 포화와 클라이언트 캡처 큐 포화, 마이크 단절 오류와 새 스트림 복구.
- 오래된 화면 출력 거절, 화면·음성 오류 분리, 텍스트 fallback용 화면 복구.
- 귀 보정 게이트, 좌우 반전·펄스 범위, 서보 오류·연결 종료·heartbeat 만료 후 비활성화.
- 단일 제어 연결, 중복 commandId 거절, 잘못된 패킷 후 재연결.
- Swift 예제의 화면·음성·귀 제어와 재생 중 마이크 프레임 수신.
- Linux 실제 모드의 장치 누락 오류. 장치가 없을 때 모의 성공으로 자동 전환하지 않음.
- 실제 ALSA API의 null 플러그인 재생. USB 스피커 성능 검증과는 별개.

실행 방법은 README와 `tools/check-linux.sh`에 있습니다. GUI 없는 CI에서는 `tests/visual.py`가 SDL dummy video backend로 **제품과 같은 렌더링 코드**를 실행합니다. 광학적 패널 확인은 아닙니다.

## 실물 도착 후

실측값과 통과 여부는 하드웨어 연결 후 기록합니다. 아래 항목은 아직 통과 기록이 아닙니다.

| 순서 | 확인 | 합격 기준 |
| --- | --- | --- |
| 1 | 보드·OS·캐리어 | 모델·JetPack·OE=GND·I2C 어댑터를 설정 및 배선과 대조 |
| 2 | 서보 전원·OE | 독립 5V와 공통 GND 확인, 부팅 중 출력 비활성 상태를 측정 |
| 3 | LCD | 7인치 LCD (C) 1024×600 인식, 가로 0도, 모든 표정, 한글 줄바꿈, 잘림 없음. 터치 신호가 Jetson에 입력 장치로 잡히는지 확인 |
| 4 | 마이크 | 5초 녹음 파일의 길이·형식이 맞고 사람 목소리를 식별 가능 |
| 5 | 스피커 | 낮은 음량부터 테스트음·녹음 파일 재생, 잘림·왜곡·채널 오배선 없음 |
| 6 | 동시 입출력 | 재생 중 연속 캡처 유지, 프레임 유실·ALSA XRUN 없음. 반향은 별도 측정 |
| 7 | 귀 보정 | 혼 분리 중립 확인 후 기구를 장착하고 좌우 방향·끝점·간섭·떨림 확인 |
| 8 | 통합 출력 | speaking과 재생 시작/완료 일치, 스피커 실패 시 업무 상태 보존·텍스트 안내 |
| 9 | 취소·연결 종료 | 재생 중단, 귀 PWM FULL_OFF, 화면 대기 복귀. 외부 업무 재실행 없음 |
| 10 | 재시작·로그인 | 그래픽 로그인 후 서비스 기동, 로그아웃·정상 종료·재실행 동작 확인 |
| 11 | 예비 반복 구동 | 30분 전체 동작, 메모리 증가·오류·전원 리셋 없음. H11 최종 시험과 구분 |
| H10 | 자기 음성 차단 | 사용자 발화 없이 TTS 50건, 자기 음성 업무·도구 실행 0건. 정지+300ms, 늦은 프레임·STT final 폐기 |
| H11 | 최종 케이스 | 닫힌 케이스에서 2시간 전체 반복, OOM·충돌·전원 리셋 0, 냉각·마이크·배선 간섭 없음 |

강제 종료·전원 순서·커널 정지·I2C 단절 시 PWM 유지 여부를 별도로 측정합니다. OE=GND 구성은 소프트웨어가 쓰기를 못 하면 차단을 보장하지 않습니다. 불확실하면 서보 전원을 끄고 회로를 확인합니다.

## 남아 있는 통합 경계

2026-10-25에는 팀 저장소 `a70067b`의 공개 protocol을 기준으로 `DeskPetHardwareIntegration`을 추가해 실제 소켓 연결과 DTO 변환·타이머 수명·출력 ID 보존을 시험했습니다. 10월 12일 위키에 기록된 팀 로컬 서버 연결부는 이 원격 기준에 없었습니다. 실제 STT/VAD/AEC·TTS 모델의 PCM, 외부 업무 API, Jetson 장치는 여전히 별도 검증 대상입니다.

## 팀 파이프라인 연결 합격 기준

2026-10-12에 Swift 화면 매핑 함수를 실제 패키지 모듈로 타입 검사해 통과했고, 소켓 JSON 예제는 SDL 모의 서버에서 표시 성공·ID·revision을 확인했습니다. 활동 5종·결과 3종·한글 대체 문구·잘못된 활동값 거절도 확인했습니다. 아래 기준은 2026-10-25 mock 통합의 회귀 기준이며, 실제 모델·장치 연결 후에도 다시 확인합니다.

- 성공·실패·결과 미확인 각각이 [표정 명세](https://github.com/hansung-capstone-team-8-new-line/knowledge/blob/master/wiki/deskpet-display-interface.md)의 매핑대로 표시되는지 확인한다.
- 답변을 만드는 동안 `processing`, 실제 재생 시작 뒤 `speaking`이 되는지 확인한다.
- 일반 응답과 재질문을 구분하고 질문 재생 완료 후에만 `awaiting_answer`로 바꾸는지 확인한다.
- 음성 실패 후 같은 ID·같은 업무 결과의 짧은 텍스트를 보내는지 확인한다.
- 텍스트 타이머가 끝나기 전에 새 요청이 오면 예전 타이머가 새 화면을 지우지 않는지 확인한다.
- 모델이 `cheerful` 또는 모순된 결과·감정을 내보내도 연결 검증에서 허용 값과 일관된 조합으로 바꾸는지 확인한다.
- 실제 팀 타입을 하드웨어 `OutputEvent`로 변환하는 래퍼가 컴파일되는지 확인한다.

## Current Profile Verification — 2026-10-13

RC070S 1024×600·ReSpeaker Lite·OE=GND 기준으로 다음 검사를 실행했다.

- Ubuntu 22.04 WSL x86_64 / GCC 11.4: C++20 실제 ALSA·I2C·SDL·SoXR 드라이버 빌드, core 및 current-profile 검사 통과.
- Unix socket 통합 **17개 전부 통과**. Swift 왕복, 취소·재생 drain·큐 포화·단절·정지 미확인 오류를 포함한다.
- Swift **5.10.1** 제품 strict-concurrency·warnings-as-errors 빌드 및 왕복 통과. 이 버전의 XCTest 자동 생성 코드 strict 경고는 제품 코드와 구분한다.
- Swift **6.0.3** strict-concurrency·warnings-as-errors 빌드와 XCTest **9개 전부 통과**. 실소켓 gate 검사는 정지+300ms·fresh frame·late epoch 거절·정지 미확인 차단 유지를 확인했다.
- SoXR 검사: 입력 8/16/22.05/24/44.1/48kHz × mono/stereo **12개 조합**, 1초 입력의 16kHz 출력 길이, 청크 분할 동등성, 진폭 상한, 역상 stereo 모노 혼합 검증.
- 레지스터 전송 검사: 초기화·비활성 preload·두 채널 활성화·FULL_OFF·부분 I2C 실패·정지 쓰기 실패. PWM count는 단일 I2C 전송으로 갱신한다.
- RC070S 1024×600·0/90도 **16개 SDL 화면**, 한글·텍스트 overflow 거절 검사 통과. 가로 한글·듣기 화면을 직접 확인했다.
- `bash -n` 설치/검증 도구, `git diff --check`, 충돌 stage/marker 검사 통과. 위키와 현재 수정 문서의 **553개 링크 검사**, 알려진 깨진 링크 5개 수정 후 0개. vault frontmatter·memory·raw/archive·next_action 검사 통과.
- 최신 데이터 생성 코드·small-router-model 및 파이프라인 하위 문서는 `fddfa28`과 동일함을 Git diff로 확인했다. 기존 merge 양쪽 커밋과 stash 2개를 보존했다.

 당시 기준 화면은 RC070S 7인치였다. 2026-10-16 발주한 10.1인치 LCD와 2026-10-26 재구매 계획의 7인치 LCD (C)도 1024×600이라 화면 검사 결과는 그대로 적용되지만 실물 인식은 확인하지 않았다. 실물 Jetson·LCD·ReSpeaker·SG90는 연결하지 않았으므로 H10/H11과 실제 출력 전력·열·전원 장애 시험은 미실행이다.
