hansung-capstone-team-8-new-line/deskpet-hardware/hardware-design/kicad-wiring/erc-result-screenshot.png

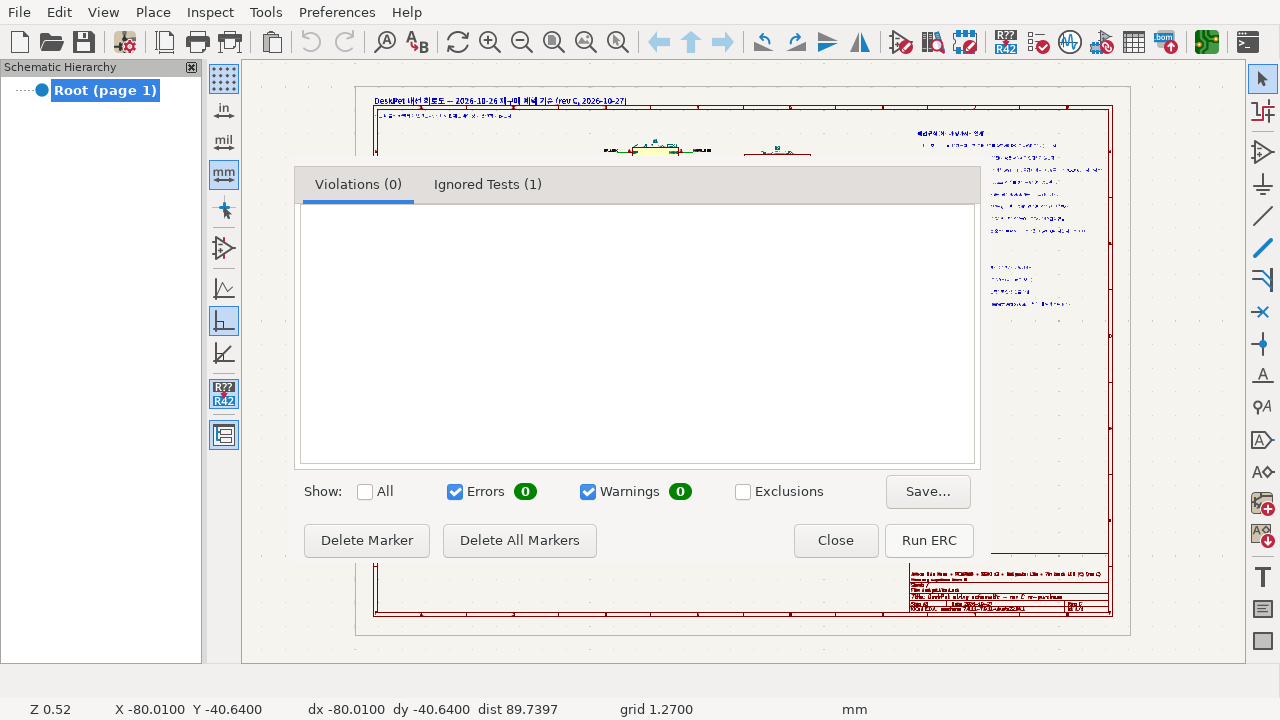
hardware-design/kicad-wiring/erc-result-screenshot.png
