hansung-capstone-team-8-new-line/deskpet-hardware/hardware-design/kicad-wiring/deskpet.kicad_sch

## KiCad design hardware-design/kicad-wiring/deskpet.kicad_sch (2026-10-27)

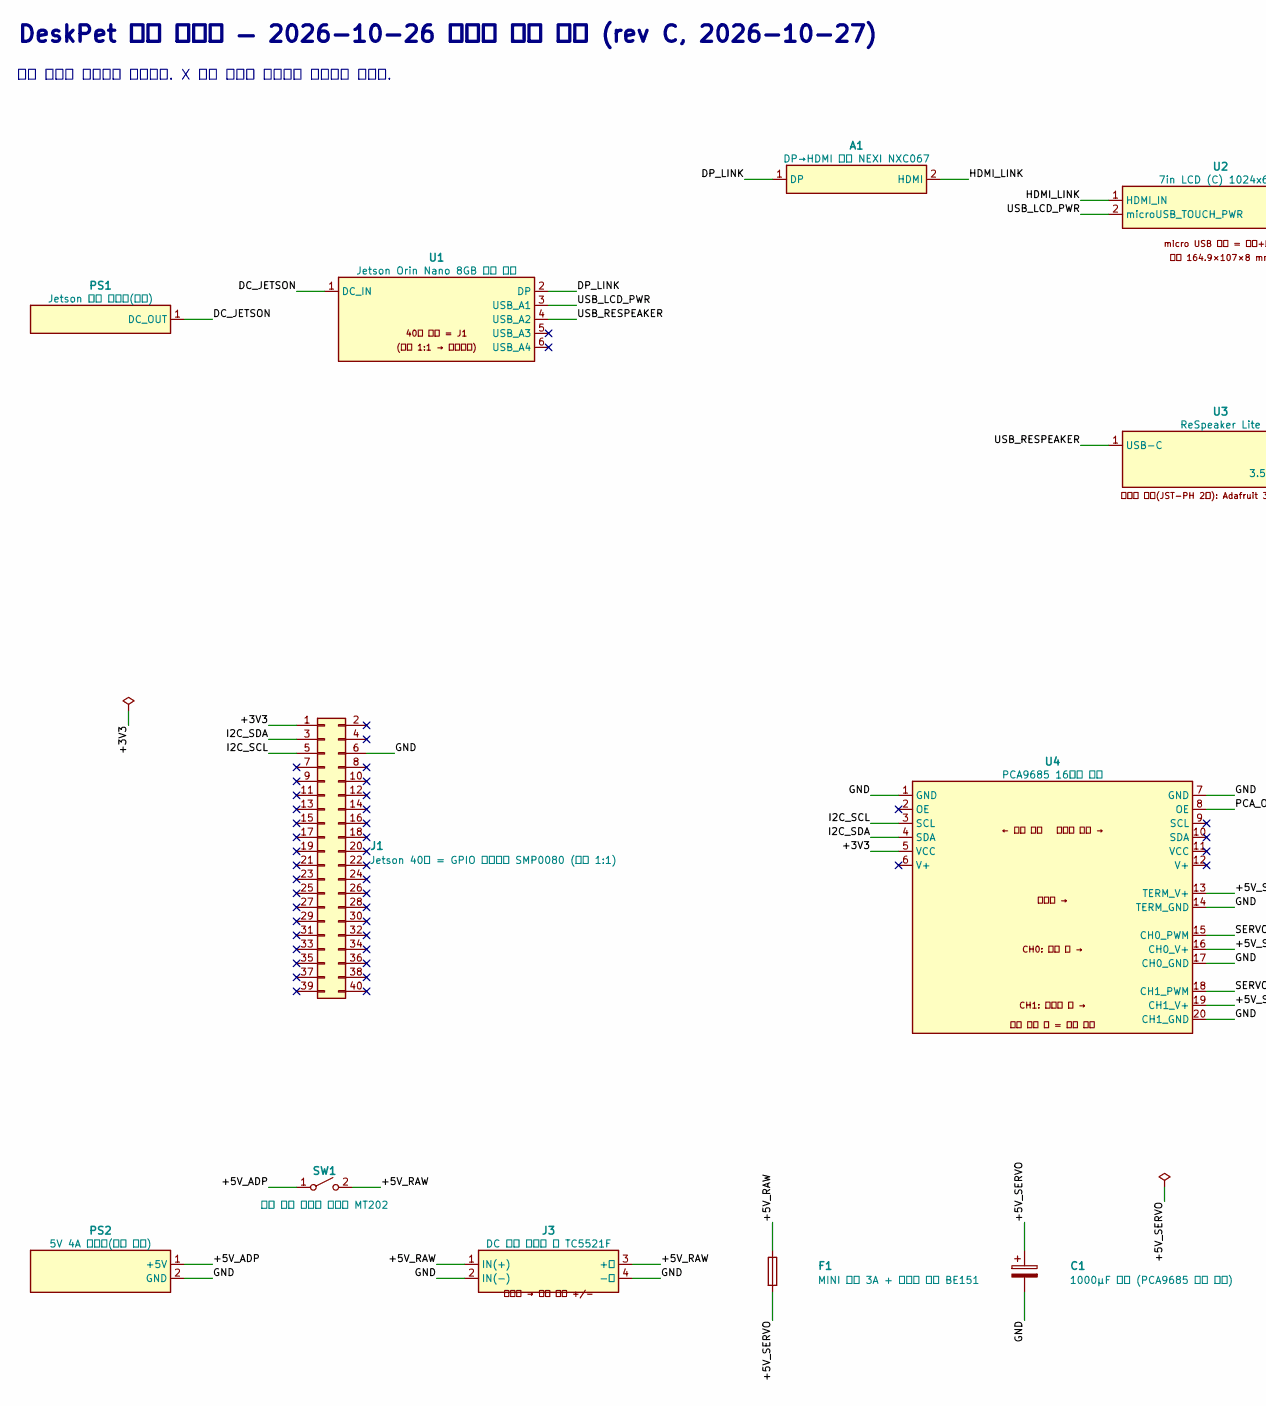
[picture p25: schematic deskpet.kicad_sch, part in row 1, column 1]

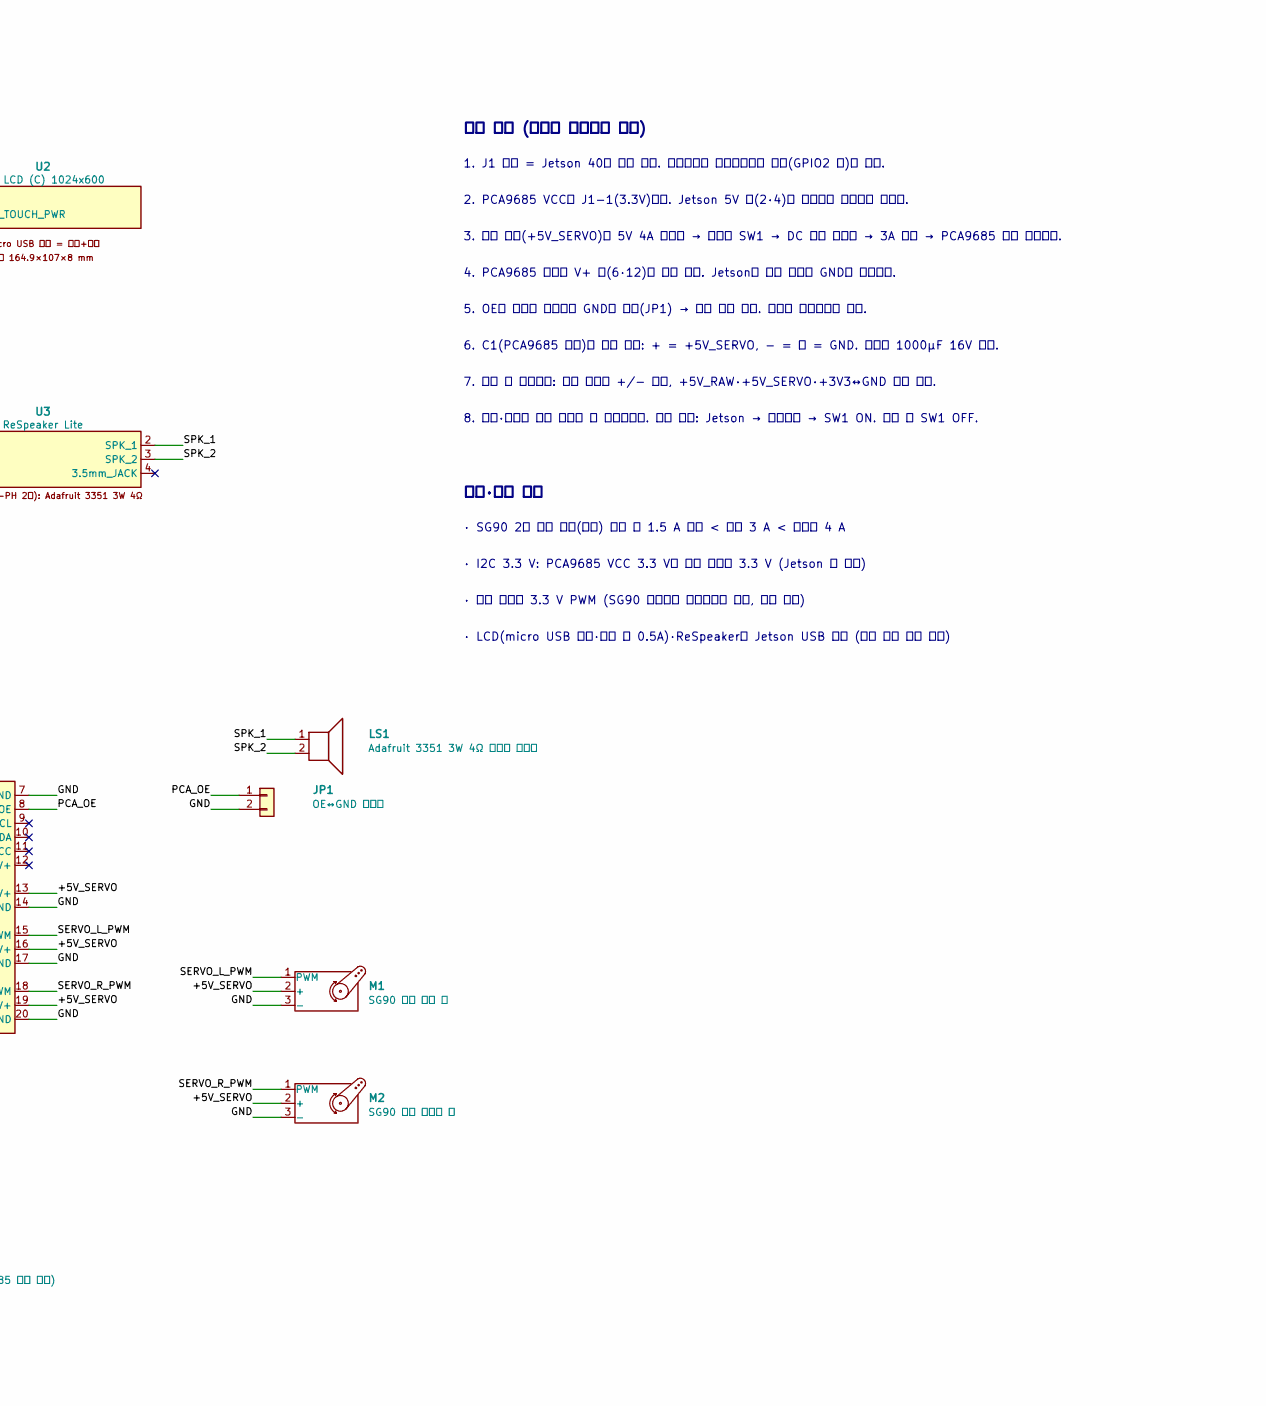
[picture p26: schematic deskpet.kicad_sch, part in row 1, column 2]

Parts:
A1: DP→HDMI 젠더 NEXI NXC067
C1: 1000µF 전해 (PCA9685 보드 내장)
F1: MINI 퓨즈 3A + 인라인 홀더 BE151
J1: Jetson 40핀 = GPIO 분배보드 SMP0080 (리본 1:1)
J3: DC 클립 터미널 암 TC5521F
JP1: OE↔GND 점퍼선
LS1: Adafruit 3351 3W 4Ω 밀폐형 스피커
M1: SG90 호환 왼쪽 귀
M2: SG90 호환 오른쪽 귀
PS1: Jetson 전원 어댑터(키트)
PS2: 5V 4A 어댑터(서보 전용)
SW1: 서보 전원 스위치 연장선 MT202
U1: Jetson Orin Nano 8GB 개발 키트
U2: 7in LCD (C) 1024x600
U3: ReSpeaker Lite
U4: PCA9685 16채널 모듈

Connections:
+3V3: J1.1, U4.5 (VCC)
+5V_ADP: PS2.1 (+5V), SW1.1 (A)
+5V_RAW: F1.1, J3.1 (IN(+)), J3.3 (+선), SW1.2 (B)
+5V_SERVO: C1.1, F1.2, M1.2 (+), M2.2 (+), U4.13 (TERM_V+), U4.16 (CH0_V+), U4.19 (CH1_V+)
DC_JETSON: PS1.1, U1.1 (DC_IN)
DP_LINK: A1.1 (DP), U1.2 (DP)
GND: C1.2, J1.6, J3.2 (IN(-)), J3.4 (-선), JP1.2, M1.3 (-), M2.3 (-), PS2.2 (GND), U4.1 (GND), U4.7 (GND), U4.14 (TERM_GND), U4.17 (CH0_GND), U4.20 (CH1_GND)
HDMI_LINK: A1.2 (HDMI), U2.1 (HDMI_IN)
I2C_SCL: J1.5, U4.3 (SCL)
I2C_SDA: J1.3, U4.4 (SDA)
PCA_OE: JP1.1, U4.8 (OE)
SERVO_L_PWM: M1.1 (PWM), U4.15 (CH0_PWM)
SERVO_R_PWM: M2.1 (PWM), U4.18 (CH1_PWM)
SPK_1: LS1.1, U3.2 (SPK_1)
SPK_2: LS1.2, U3.3 (SPK_2)
USB_LCD_PWR: U1.3 (USB_A1), U2.2 (microUSB_TOUCH_PWR)
USB_RESPEAKER: U1.4 (USB_A2), U3.1 (USB-C)

Notes on the sheet:
DeskPet 배선 회로도 — 2026-10-26 재구매 계획 기준 (rev C, 2026-10-27)
같은 이름의 라벨끼리 연결된다. X 표시 핀에는 아무것도 연결하지 않는다.
배선 규칙 (회로가 망가지지 않게)
1. J1 번호 = Jetson 40핀 물리 번호. 분배보드의 라즈베리파이 이름(GPIO2 등)은 무시.
2. PCA9685 VCC는 J1-1(3.3V)에만. Jetson 5V 핀(2·4)은 어디에도 연결하지 않는다.
3. 서보 전기(+5V_SERVO)는 5V 4A 어댑터 → 스위치 SW1 → DC 클립 터미널 → 3A 퓨즈 → PCA9685 나사 단자로만.
4. PCA9685 헤더의 V+ 핀(6·12)은 연결 금지. Jetson과 서보 전원은 GND만 공유한다.
5. OE는 오른쪽 헤더에서 GND와 점퍼(JP1) → 출력 항상 활성. 끄기는 프로그램이 담당.
6. C1(PCA9685 내장)은 극성 확인: + = +5V_SERVO, − = 띠 = GND. 없으면 1000µF 16V 추가.
7. 꽂기 전 멀티미터: 클립 터미널 +/− 확인, +5V_RAW·+5V_SERVO·+3V3↔GND 단락 없음.
8. 연결·분리는 모든 전원을 끈 상태에서만. 켜는 순서: Jetson → 프로그램 → SW1 ON. 이상 시 SW1 OFF.
전류·정격 점검
· SG90 2개 동시 정지(스톨) 합계 약 1.5 A 이하 < 퓨즈 3 A < 어댑터 4 A
· I2C 3.3 V: PCA9685 VCC 3.3 V라 모듈 풀업도 3.3 V (Jetson 핀 보호)
· 서보 신호는 3.3 V PWM (SG90 입력으로 일반적으로 인식, 실물 확인)
· LCD(micro USB 터치·전원 약 0.5A)·ReSpeaker는 Jetson USB 사용 (최대 밝기 전류 실측)
