hansung-capstone-team-8-new-line/deskpet-hardware/(commit log)

2026-10-13 Align RC070S and ReSpeaker profile with grounded-OE control and input gating
2026-10-25 docs: collect hardware design sources and technical docs here
    Move the current KiCad wiring sources out of the team wiki (knowledge)
    so this repository holds the technical material, and add architecture,
    device behaviour, and mock-run/troubleshooting docs. Fold the wiki-only
    protocol and integration-acceptance sections into docs/.
    Align the docs with the 2026-10-16 parts order: 10.1-inch touch LCD
    (1024x600, mini HDMI, USB-C touch), ReSpeaker Lite kit speaker, DC
    extension lead and T-Cobbler breakout. Touch input is not implemented
    and the KiCad exports still show the 2026-10-13 part names.
    [deskpet.kicad_sch, wiring-table.csv]
2026-10-25 hardware-design: regenerate wiring as rev B and add assembly figures
    Regenerate the KiCad schematic, netlist, BOM, PDF/PNG, ERC report and
    wiring table with the 2026-10-16 ordered part names (10.1-inch touch
    LCD, DC extension lead, T-Cobbler, ReSpeaker kit speaker). Connections
    are unchanged: ERC 0 errors/0 warnings, netlist check passes and all six
    mutation cases still fail as expected.
    Add assembly-figures/make_figures.py, which draws the 15 assembly
    manual figures and the enclosure layout from one dimension table
    (case plan rev B, 282 x 160 x 150 mm from the seller's LCD drawing).
    [deskpet.kicad_sch, wiring-table.csv]
2026-10-25 feat: prepare Orin Nano board tests and touch integration
2026-10-25 docs: refresh device and architecture integration status
2026-10-26 docs: update hardware design to the rev C re-purchase
    Retarget docs, assembly figures and the wiring table to the 2026-10-26
    re-purchase: Waveshare 7-inch HDMI LCD (C) (same 1024x600, no code or
    config change), ReSpeaker Lite with an Adafruit 3351 speaker, SMP0080
    breakout and ribbon, a cord-integrated 5V 4A servo adapter with an
    inline MT202 switch, a TC5521F clip terminal, and the PCA9685 module's
    onboard 1000uF capacitor. The enclosure plan becomes 204 x 122 x 150 mm
    and prints without splitting.
    Nets are unchanged and verify.py still passes against the existing
    netlist; the wiring table lists the switch as row S1. The schematic
    sources keep rev B part names until the KiCad regeneration,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
    [wiring-table.csv]
2026-10-26 docs: switch enclosure fasteners from M3 to M2.5
    The Jetson carrier and Pi-style boards use M2.5 holes, which M3 hardware
    does not fit; M2.5 also passes through the 3 mm holes on the LCD and
    PCA9685 module. Update the figure labels and regenerate nothing else.
    [make_figures.py]
2026-10-26 docs: mount the Jetson on its kit base without screws
    The carrier's mounting hole size is not published, so the tray now holds
    the Jetson by its stock plastic base with a pocket, end stops and hold-down
    lips instead of standoffs. The ReSpeaker is clamped as well; M2.5 nylon is
    kept for the LCD, PCA9685, breakout and case joints.
2026-10-27 hardware-design: regenerate the rev C schematic with the servo power switch
    Add the MT202 servo power switch (SW1) between the 5V 4A adapter and the
    DC clip terminal, introducing the +5V_ADP net. Regenerate the schematic,
    PDF/PNG, netlist, BOM, ERC and wiring table with KiCad 7.0.11 so every
    output uses rev C part names.
    - verify.py: 17 golden nets, new "switch bypassed" safety rule
    - gen.py: switch_bypassed mutation (7 mutations, all FAIL as expected)
    - wiring_table.py: W6/S1 rows go through SW1; fix last row overlapping the footer
    - ERC 0 errors / 0 warnings, wiring table 19 rows consistent
    [deskpet.kicad_sch, wiring-table.csv]
2026-10-27 feat(hardware-design): add parametric case 3D model with fit checks
    Model the rev C enclosure in build123d with the purchased parts and
    cable routes in the same coordinates. build.py checks part/part and
    cable/part interference, the 30 mm fan air gap, ear swing (±30°), the
    Jetson tray slide-out path and print-bed fit, then exports per-part STL,
    an assembly STEP and VTK renders.
    Design changes from the wiki plan (need team review): LCD slides in from
    the top and is held by a P3 rib (no P9 clamps), right-angle HDMI and
    micro USB plugs, Jetson ports reached through the back panel with a cable
    pass-through, GPIO breakout on the left wall, ear servos front-to-back.
    Values marked [추정] must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
    [P1-base.stl, P2-body.stl, P3-top.stl, P4-back.stl, P5-tray.stl, P6-ear-x2.stl, P7-speaker-cradle.stl, deskpet-case-assembly.step]
2026-11-01 feat(display): render faces as soft dot-matrix in the SDL renderer
    Port the face catalog into display.cpp: faces are SDF layers sampled
    per dot, with edge dots drawn smaller and dimmer, a cached unlit grid,
    and a half-resolution glow. Adds display.face (dotSize, whiskers,
    mouth, glow), whiskers by default, a talk-only cat mouth, and the
    hardware emotions petted/sleepy/surprised. The CLI gains --emotion and
    the visual test renders all twelve faces.
2026-11-01 feat(hardware-design): redesign the case as rev D with a full-front LCD
    Drop the 30 mm side cable bay so the 7inch LCD (C) fills the front with an
    even 13.5 mm bezel (192 x 134 x 150 mm). The LCD is screwed through its
    corner tabs to front-frame bosses, and right-angle HDMI FPC / micro USB
    plugs hide in the 11 mm right margin.
    - Tray and rear door are one part: two screws release the Jetson for
    return without opening the back panel
    - Ears get a mechanical stop (M2.5 screw in a hub groove, about +/-32 deg)
    and an optional two-colour inner-ear insert
    - Export print-oriented STLs and Bambu X1C/H2D plate 3MFs; add PRINTING.md
    - New checks: ear stop engages, board return path, ear weight
    Co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
    [H2D-1-P1-base-P3-top.3mf, H2D-2-P4-back-P7-ears.3mf, P1-base.stl, P2-body.stl, P3-top.stl, P4-back.stl, P5-tray-door.stl, P5-tray.stl]
2026-11-02 feat(display): animate faces with spring poses and random variations
    Faces are now a pose (gaze, tilt, scale, lids, mouth, whiskers) that springs
    toward a target built from the activity's base pose, the emotion's lid and
    mouth shifts, and a randomly picked variation. States read through gaze and
    motion: listening leans in and nods, processing looks up and away, awaiting
    an answer tilts the head. Each state has 2-7 variations that never repeat
    back to back; blinks, micro-saccades and syllable-like mouth openings are
    randomized too. A state change starts with a blink instead of a cross-fade.
    - Solid eyes without highlights, larger (64x90), soft vertical shade; blue body
    - Every dot is the sam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
2026-11-02 feat(display): livelier eyes and gentler smiles
    - Add one small, pale catchlight per eye that drifts slightly against the
    gaze, plus a very slight breathing of the eye height
    - Smiling now squashes and lifts the eye instead of cutting it from below,
    which read as puffed cheeks; only a strong smile (beaming, petted "좋아",
    yawning) turns into a closed ^ arc
    - Tone down happy and petted: smaller bounce, tilt, whisker and scale changes
    - Catalog page and docs follow the same eyes
    [display.cpp]
2026-11-02 feat(display): drive the speaking mouth from the played speech level
    The playback thread now feeds the display a 20 ms RMS envelope of each
    speaker.write chunk (-48..-14 dBFS mapped to closed..open, before playback
    gain), anchored to the moment the output device starts playing. While the
    pet is speaking and audio is playing through the daemon, the mouth follows
    that envelope; silence closes it. Without daemon playback (the Mac demo or
    a speaking state with no audio) the random syllable rhythm remains.
    - New display.face.lipSyncDelayMs (0-500, default 0) shifts the mouth to
    match speaker latency on the real board
    - Unit test checks silence vs tone on the playback clock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
2026-11-02 fix(display): keep the mouth closed when no speech is playing
    The speaking mouth fell back to a random syllable rhythm whenever no audio
    was playing through the daemon. That rhythm never matched the speech and
    kept the mouth moving in pauses and after the audio ended, so the mouth now
    stays closed unless the played speech level opens it. The catalog page
    keeps its random rhythm as a preview only.
    [display.cpp]
2026-11-03 feat(display): use the cat ω mouth in every state
    Every state now keeps the idle ω mouth at the same size instead of
    switching to lines, half-moons, ∩ or o shapes. Emotion tilts the two
    lobes about the middle peak (up for smiles, down for sad), MouthWave
    wobbles them, and speaking, surprise, sleepiness and yawns open a small
    mouth below the peak. MouthCat and MouthWidth are gone along with the
    curved-line mouth. The catalog page and docs follow.
    [display.cpp]
2026-11-03 feat(display): touch, listening ripples, state glow and time-of-day reactions
    The face now reacts to what the hardware senses directly, on top of the
    activity/emotion/actionStatus view, without new interface fields:
    - Touch (SDL touch, and mouse in mock mode): look at the finger and lean
    in, glance at a tap, double-blink when an eye is tapped, and show the
    petted face for 3 s when rubbed. Works with or without touch.subscribe.
    - Listening: up to three sound ripples beside the face that breathe on
    their own and swell with the microphone level from capture.
    - State glow on the unlit dots: listening sky blue, processing violet,
    awaiting_answer amber.
    - Time of day (display.face.timeOfD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
    [config.cpp, display.cpp, display.hpp, runtime.cpp, types.hpp, visual.py]
2026-11-03 feat(display): more touch gestures, pink petting glow and dot waves
    - Petting no longer draws red cheek circles: like the other states, the
    unlit dots wash pink while the features stay blue (Blush key removed)
    - Touch gestures: long press leans in with closed eyes, tapping the mouth
    goes "nom", tapping a whisker twitches it, a double tap beams, four
    quick taps startle (over a beam), and a swipe makes the eyes chase it
    - Dot waves: a band of dots lights up as a ring spreads and fades, used
    sparingly for touches, double taps, swipes, the start of petting
    (pink), the start of listening, waking from a doze and success
    (replacing the success ring)
    - Catalog page and docs follow
    Co-Au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
    [display.cpp]
2026-11-07 feat(hardware-design): make the case cuter as rev E and plan H2D prints
    Rev E keeps the rev D size and internals but reworks the exterior after
    feedback that the case did not look cute enough:
    - Round the outer edges (front R10, back R8, top R8, bottom R3) and the
    screen window (R2 -> R18), with inner fill where the top fillet thins
    the walls.
    - Reshape the ears (base 50, tip R12, leaning 12 deg outward), move them
    inward and forward, and hide the servo hub inside a concave ear root.
    - Replace the two-colour inner-ear insert with a 0.4 mm recess to paint.
    - Add printed round feet (P8) that sink the purchased bumpers 3 mm.
    - Move the ReSpeaker back 34 mm and reroute its USB, the speake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
    [H2D-0-P2-fit-test.3mf, H2D-1-P1-base-P3-top.3mf, H2D-1-P2-body-P4-back-P5-tray.3mf, H2D-2-P1-base-P3-top-P6-ears-P7-P8.3mf, H2D-2-P4-back-P7-ears.3mf, P1-base.stl, P2-body.stl, P3-top.stl]
2026-11-09 fix(hardware-design): make bed-side edges printable without supports
    Bambu Studio flagged the back plate as floating: the rev E fillets on
    the edges that sit on the build plate (P1 bottom, P2 front, P3 top,
    P4 back) started tangent to the bed, so the first layers had nothing
    under them. Rebuild the envelope from three printable profiles: each
    bed-side corner now starts with a 45 deg line and rounds into the side
    face, and the top-front and top-back edges, which touch the bed for two
    parts, become 45 deg chamfers.
    Also seat the tray door on the bed (it floated 0.3 mm, left from rev D),
    chamfer the bed side of the feet, and add a build check that fails when
    any part has sloped overhangs withi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
    [H2D-0-P2-fit-test.3mf, H2D-1-P2-body-P4-back-P5-tray.3mf, H2D-2-P1-base-P3-top-P6-ears-P7-P8.3mf, P1-base.stl, P2-body.stl, P3-top.stl, P4-back.stl, P5-tray-door.stl]
2026-11-09 feat(hardware-design): split H2D prints into three spaced jobs in PLA
    The two production plates packed parts 10-12 mm apart, and plate 1 was
    310 mm wide, running into the H2D's one-nozzle-only strips. Split the
    print into three jobs (P2+P7+feet, P1+P4, P3+P5+ears) with 20 mm gaps,
    each at most 171 g, and check in build.py that every plate stays inside
    the central 275 x 300 mm of the bed.
    The only filament on hand is Bambu PLA Basic, so the plan, weights and
    PRINTING.md now use PLA, with a heat check after assembly and a fallback
    of reprinting only P4 and P5 if they get too warm near the Jetson.
    [H2D-0-P2-fit-test.3mf, H2D-1-P2-body-P4-back-P5-tray.3mf, H2D-1-P2-body-P7-P8-feet.3mf, H2D-2-P1-base-P3-top-P6-ears-P7-P8.3mf, H2D-2-P1-base-P4-back.3mf, H2D-3-P3-top-P5-tray-P6-ears.3mf, deskpet-case-assembly.step]
